farvanyoshi/battery-science-project/assets/images/method/zinc-chloride.jpg

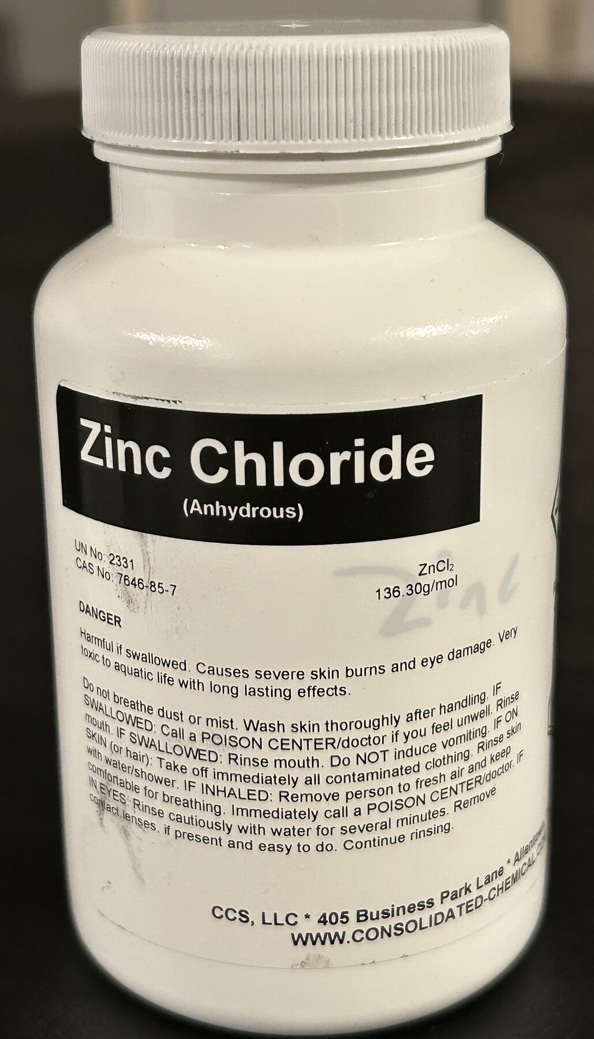
assets/images/method/zinc-chloride.jpg
