farvanyoshi/battery-science-project/assets/images/method/first-battery.jpg

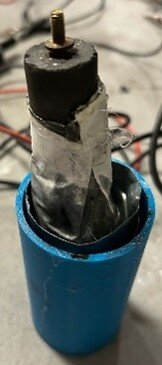
assets/images/method/first-battery.jpg
