farvanyoshi/battery-science-project/docs/abstract.pdf

Abstract
As the world transitions to renewable sources o energy, massive grid energy storage will be necessary to accommodate the variable output o these sources. Grid solutions must be ecient, sustainable, aordable, and scalable to keep up with ever-increasing demand. While lithium-ion batteries are the current frst choice or grid storage, zinc-ion batteries (ZIBs) are more sustainable and cost-eective. ZIBs have more abundant materials, lower prices, and less potential or harm. This study assesses the perormance o zinc-ion batteries made using consumer-grade materials to determine the easibility o these batteries on a commercial scale. Variations in the composition o the cathode and electrolyte were evaluated or improvements in the discharge profles and overall perormance.

Despite the heavy limitations placed on battery construction by the low-quality materials and simpler design, the batteries were able to eectively charge and discharge without a considerable loss in capacity. It was ound that the zinc chloride used in later iterations was a more dangerous and unstable electrolyte, while the addition o manganese dioxide showed substantial improvement to battery perormance in Iteration 5. Issues including short-circuiting and gas evolution while recharging demonstrated the need or improved design and construction. Nevertheless, the fndings o this experiment underscore the usage zinc-ion batteries or grid storage while emphasizing the need or signifcant optimizations in the eciency, stability, and longevity o zinc-ion batteries. Thus, this proo-o-concept study provides a oundation or urther research into aordable and sustainable battery technologies.
