farvanyoshi/battery-science-project/assets/images/intro/li-ion-discharge.png

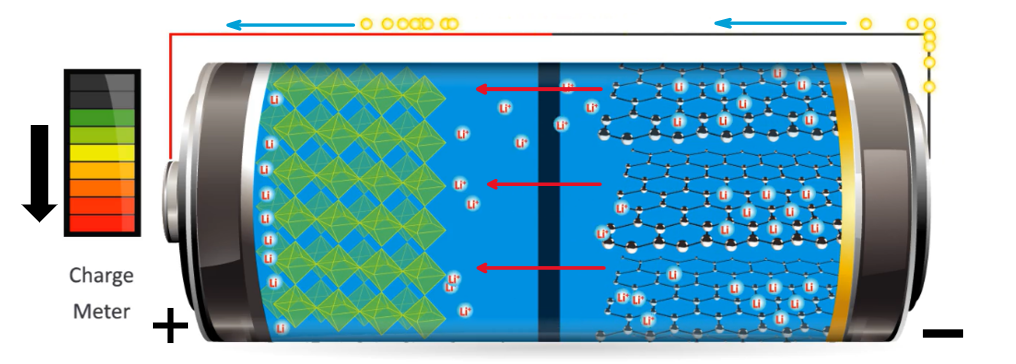
assets/images/intro/li-ion-discharge.png
