farvanyoshi/battery-science-project/assets/images/method/charge-schematic.png

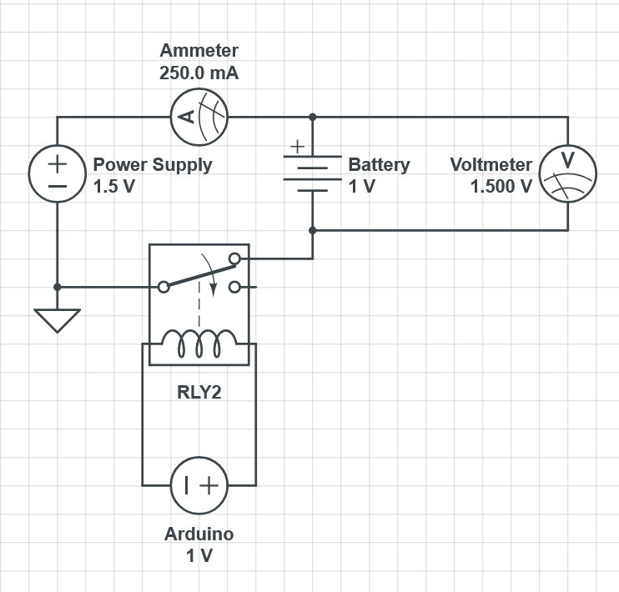
assets/images/method/charge-schematic.png
