farvanyoshi/battery-science-project/assets/images/method/current-probe.jpg

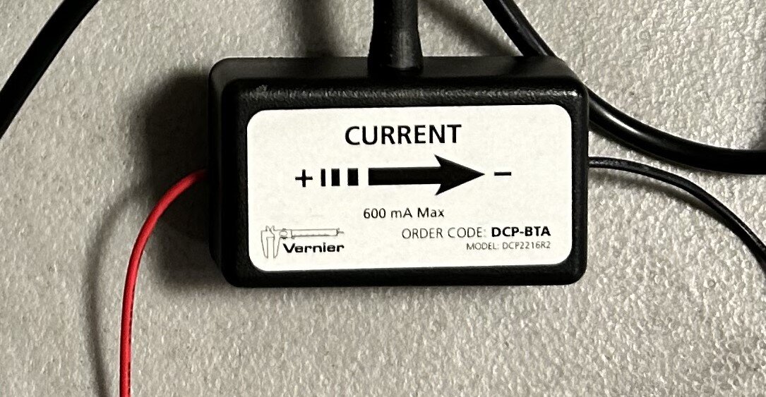
assets/images/method/current-probe.jpg
