farvanyoshi/battery-science-project/assets/images/method/discharge-schematic.png

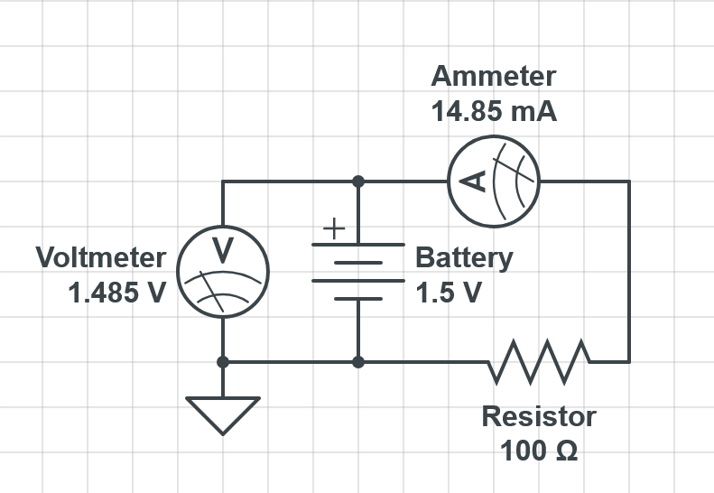
assets/images/method/discharge-schematic.png
