farvanyoshi/battery-science-project/assets/images/method/manganese-dioxide.jpg

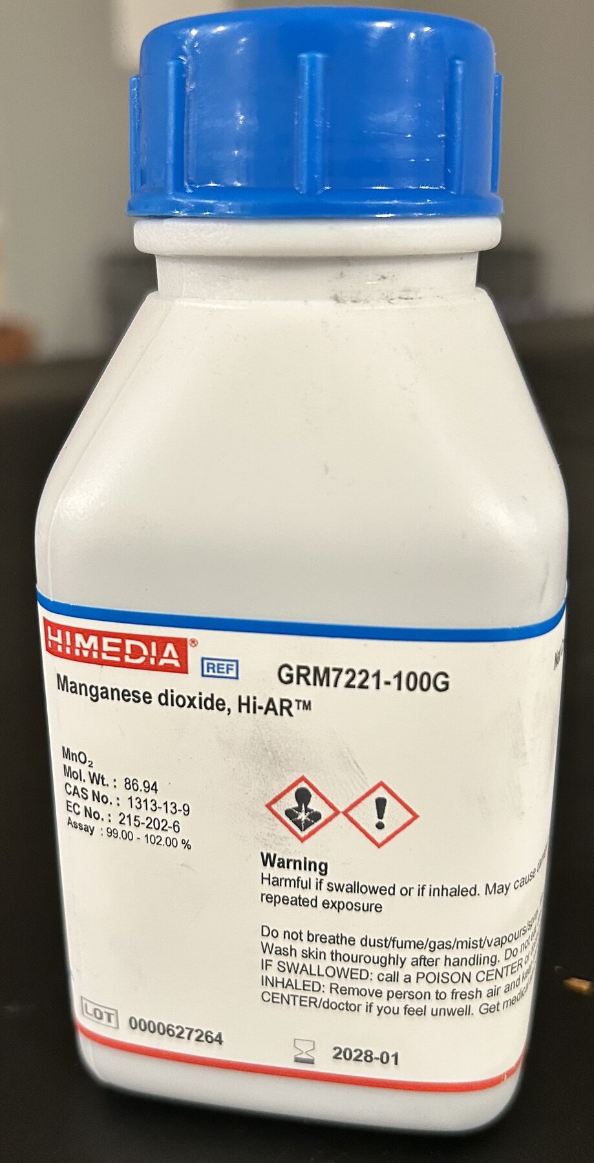
assets/images/method/manganese-dioxide.jpg
