farvanyoshi/battery-science-project/docs/VERIFICATION.md

# Verification against the submitted paper

Generated by `python -m zinclab verify` (or `make verify`). Every graph, table and number in the submitted paper
(January 2025) was compared with the data book ([`data/raw/the-data-book.xlsx`](../data/raw/the-data-book.xlsx),
through the tidy files in [`data/tidy/`](../data/tidy)). Values are compared at the precision they were printed
with. Do not edit this file by hand.

## Summary

- **Data.** The data book holds the same readings as the Logger Pro files the original graphs were made from,
  except for the few cells listed below. The tests in `analysis/tests/test_book.py` check this reading by reading.
- **Graphs.** The 31 graphs are redrawn from the data book. Of the 448 values in the statistics and integral
  boxes of the original graphs, all are reproduced except in 5 boxes, and each of those is
  explained below.
- **Curve fits.** The fits are now done on the data book's readings. They give the same coefficients,
  uncertainties, correlations and RMSEs as the original graphs.
- **Effective capacity and energy (Tables 1–4).** The submitted values were wrong. The data book formula added
  up the samples instead of integrating over time, so every value was too large by the number of samples per
  minute (6 for Iteration 2, 30 for Iterations 3 and 4). In three cells, the formula pointed at the wrong columns.
  The tables in the paper now use the integrals, and the sentences that compared these values were updated.
- **Internal resistance (Tables 5–6).** These were worked out by hand from EMF readings that are not all in the
  saved data, so they could only be partly checked. They are unchanged in the paper. See the notes below.
- **Numbers in the text.** 35 quoted values were checked. 4 were wrong and are corrected in
  the paper. The rest match.

## Changes made to the paper

| Where | Submitted | Now |
|---|---|---|
| Method | “set to measure 30 samples per minute … 1 sample every 2 seconds” (Iteration 2) | 6 samples per minute, 1 sample every 10 seconds; Iterations 3 and 4 used 30 samples per minute |
| Discussion, @Pot3b | average voltage 0.08890 V | 0.08880 V (value on the graph) |
| Discussion, @C4-C | “down to around 0.02708 A … recorded 2.5 minutes after the first” | 0.002708 A (the median) and 1 minute |
| Discussion, @cap3 | Iteration 3's effective values were “about 5 times larger” than Iteration 2's | about the same; the factor of 5 came from the different sampling rates |
| Discussion, @cap4 | Iteration 4's first discharge had a “very high” effective capacity | it had none, because the short circuit kept the voltage below 0.9 V |
| Discussion, @cap5 | Iteration 5's values “were not impressive” | they were the largest of any iteration |
| Conclusion | “The zinc chloride-based iteration 3 had by far the greatest effective capacity and effective energy.” | Iteration 5, with manganese dioxide, had the greatest |

The effective capacity and energy tables were replaced as a whole (see below). Spelling and grammar fixes are not
listed here (see the git history).

## Data book vs. Logger Pro

Every change made while splitting the data book into [`data/tidy/`](../data/tidy) is logged in
[`data/tidy/cleaning.csv`](../data/tidy/cleaning.csv). Grouped by run:

| Run | In the paper | Book rows | Columns | Change | Reason |
|---|---|---|---|---|---|
| `iteration-1/discharge-2` | no | 426–452 | potential_v, power_w | removed (54 cells) | Broken formula in the book |
| `iteration-3/discharge-1` | yes | 79–101 | current_a, potential_v, power_w | removed (69 cells) | Probe glitch: the potential drops from 0.41 V to 0.07 V and jumps to 0.65 V (struck out in Logger Pro) |
| `iteration-4/discharge-1` | yes | 3–14403 | current_a, potential_v | swapped | The book has the potential difference and current columns swapped for this run |
| `iteration-5/discharge-2` | yes | 3–6 | potential_v, power_w | removed (8 cells) | Readings before the probe settled, including a 5.087 V spike (struck out in Logger Pro) |

The readings that were removed from runs in the paper are exactly the ones that were struck out in Logger Pro, so
the original graphs did not include them either. Apart from these, the data book and Logger Pro agree to within
Logger Pro's rounding (about 10⁻⁷).

The data book also has the full length of two runs that the paper cut short: Iteration 5's first discharge ran for
240 minutes, but the paper cut both of its discharges off at 88 minutes, and the last charge of Iteration 2 ran for
120 minutes, but the paper only used the first 60. The graphs and tables keep the paper's cutoffs
(`CUTOFF` in `analysis/zinclab/spec.py`). The normalized potential graph (Vnorm) showed the whole of each run in
the original, so it still does.

## Graph readouts

The original graphs were Logger Pro screenshots with statistics boxes (minimum and maximum with their times, mean,
median, standard deviation, sample count, Δ) and integral boxes. Their values were transcribed into
[`data/original/figure-readouts.csv`](../data/original/figure-readouts.csv) and compared with the values
recomputed from the data book.

These boxes come out differently:

| Figure | Series | Original → now | Why |
|---|---|---|---|
| Cnorm | Iteration 4, Discharge 1 | min: 0.1616 → 0.1851; min_at: 471.7 → 474.0; mean: 0.3246 → 0.3492; median: 0.2813 → 0.3055; std: 0.1438 → 0.1394 | the original graph showed Iteration 4's normalized potential here, because it was made from the data book's swapped columns (now fixed) |
| C2-C | Charge 1 | std: 0.002270 → 0.002271 | the current at 12.5 min is an average the data book keeps unrounded (0.0425911 A) where Logger Pro rounded it (0.042591 A) |
| C3-D2 | Discharge 2 (1000 ohms) | min: -9.540E-05 → -9.537e-05 | Logger Pro rounded the smallest current step to −9.54e-05 A; the data book has it in full |
| Vnorm | Iteration 4, Discharge 1 | min: 0.1851 → 0.1616; min_at: 474.0 → 471.7; mean: 0.3492 → 0.3246; median: 0.3055 → 0.2813; std: 0.1394 → 0.1438 | the original graph showed Iteration 4's normalized current here, because it was made from the data book's swapped columns (now fixed) |
| P3 | Discharge 2 (1000 ohms) | min: -8.250E-05 → -8.247e-05 | the same unrounded current step as C3-D2 |

The table lists the mean and integral of each box. The last column covers every value in the box.

| Figure | Series | n | Mean (original) | Mean (now) | Integral (original) | Integral (now) | All values in the box |
|---|---|---|---|---|---|---|---|
| Ch4 | Charge 1 | 12 | 1.108 | 1.108 | — | — | matches |
| Ch4 | Charge 2 | 17 | 0.9281 | 0.9281 | — | — | matches |
| Ch4 | Charge 3 | 12 | 1.069 | 1.069 | — | — | matches |
| Cnorm | Iteration 3, Discharge 1 | 14377 | 0.07662 | 0.07662 | — | — | matches |
| Cnorm | Iteration 4, Discharge 1 | 14401 | 0.3246 | 0.3492 | — | — | **changed** (see above) |
| Cnorm | Iteration 5, Discharge 2 | 2652 | 0.1461 | 0.1461 | — | — | matches |
| C2-C | Charge 1 | 13 | 0.04067 | 0.04067 | 2.342 | 2.342 | **changed** (see above) |
| C2-C | Charge 2 | 13 | 0.03147 | 0.03147 | 1.791 | 1.791 | matches |
| C2-C | Charge 3 | 13 | 0.06236 | 0.06236 | 3.472 | 3.472 | matches |
| C2-D1 | Discharge 1 | 2881 | 0.003698 | 0.003698 | 1.775 | 1.775 | matches |
| C2-D2 | Discharge 2 | 2881 | 0.006415 | 0.006415 | 3.079 | 3.079 | matches |
| C2-D3 | Discharge 3 | 2881 | 0.006202 | 0.006202 | 2.977 | 2.977 | matches |
| C3b | Modified Iteration 3 Discharge | 14401 | 0.001617 | 0.001617 | 0.7757 | 0.7757 | matches |
| C3-C | Charge 1 | 49 | 0.009042 | 0.009042 | 0.5137 | 0.5137 | matches |
| C3-C | Charge 2 | 49 | 0.004445 | 0.004445 | 0.2484 | 0.2484 | matches |
| Pot2 | Discharge 1 | 2881 | 0.4331 | 0.4331 | — | — | matches |
| Pot2 | Discharge 2 | 2881 | 0.6501 | 0.6501 | — | — | matches |
| Pot2 | Discharge 3 | 2881 | 0.6618 | 0.6618 | — | — | matches |
| C3-D1 | Discharge 1 (10 ohms) | 14377 | 0.003884 | 0.003884 | 1.887 | 1.887 | matches |
| C3-D2 | Discharge 2 (1000 ohms) | 14401 | 0.0006280 | 0.0006280 | 0.3014 | 0.3014 | **changed** (see above) |
| C3-D3 | Discharge 3 (100 ohms) | 14401 | 0.005154 | 0.005154 | 2.474 | 2.474 | matches |
| C4-C | Charge 1 | 49 | 0.1059 | 0.1059 | 6.221 | 6.221 | matches |
| C4-C | Charge 2 | 44 | 0.005201 | 0.005201 | 0.2187 | 0.2187 | matches |
| C4-C | Charge 3 | 49 | 0.07162 | 0.07162 | 4.197 | 4.197 | matches |
| C4-D1 | Discharge 1 | 14401 | 0.3524 | 0.3524 | 169.1 | 169.1 | matches |
| C4-D2 | Discharge 2 | 14401 | 0.0008709 | 0.0008709 | 0.4180 | 0.4180 | matches |
| C4-D3 | Discharge 3 | 14401 | 0.006575 | 0.006575 | 3.156 | 3.156 | matches |
| C5-D1 | Discharge 1 | 5303 | 0.001741 | 0.001741 | 0.1538 | 0.1538 | matches |
| C5-D2 | Discharge 2 | 2652 | 0.02385 | 0.02385 | 2.106 | 2.106 | matches |
| CS | NiMH Discharge 1 | 14401 | 0.0009516 | 0.0009516 | 0.4568 | 0.4568 | matches |
| Vnorm | Iteration 2, Discharge 1 | 2881 | 0.7294 | 0.7294 | — | — | matches |
| Vnorm | Iteration 3, Discharge 1 | 14377 | 0.1956 | 0.1956 | — | — | matches |
| Vnorm | Iteration 4, Discharge 1 | 14401 | 0.3492 | 0.3246 | — | — | **changed** (see above) |
| Vnorm | Iteration 5, Discharge 1 | 14401 | 0.7650 | 0.7650 | — | — | matches |
| Pot3b | Modified Iteration 3 Discharge | 14401 | 0.08880 | 0.08880 | — | — | matches |
| Pot3 | Discharge 1 (10 ohms) | 14377 | 0.1131 | 0.1131 | — | — | matches |
| Pot3 | Discharge 2 (1000 ohms) | 14401 | 0.8425 | 0.8425 | — | — | matches |
| Pot3 | Discharge 3 (100 ohms) | 14401 | 0.5831 | 0.5831 | — | — | matches |
| Pot4 | Discharge 1 | 14401 | 0.03041 | 0.03041 | — | — | matches |
| Pot4 | Discharge 2 | 14401 | 0.8254 | 0.8254 | — | — | matches |
| Pot4 | Discharge 3 | 14401 | 0.7268 | 0.7268 | — | — | matches |
| Pot5 | Discharge 1 | 5303 | 1.819 | 1.819 | — | — | matches |
| Pot5 | Discharge 2 | 2648 | 0.2432 | 0.2432 | — | — | matches |
| PotS | NiMH Discharge 1 | 14401 | 1.261 | 1.261 | — | — | matches |
| P2 | Discharge 1 | — | — | — | 0.7843 | 0.7843 | matches |
| P2 | Discharge 2 | — | — | — | 2.055 | 2.055 | matches |
| P2 | Discharge 3 | — | — | — | 2.031 | 2.031 | matches |
| P3 | Discharge 1 (10 ohms) | 14377 | 0.0006161 | 0.0006161 | 0.3056 | 0.3056 | matches |
| P3 | Discharge 2 (1000 ohms) | 14401 | 0.0005392 | 0.0005392 | 0.2588 | 0.2588 | **changed** (see above) |
| P3 | Discharge 3 (100 ohms) | 14401 | 0.003211 | 0.003211 | 1.541 | 1.541 | matches |
| P4 | Discharge 1 | 14401 | 0.01261 | 0.01261 | 6.052 | 6.052 | matches |
| P4 | Discharge 2 | 14401 | 0.0007199 | 0.0007199 | 0.3456 | 0.3456 | matches |
| P4 | Discharge 3 | 14401 | 0.004822 | 0.004822 | 2.315 | 2.315 | matches |
| P5 | Discharge 1 | 5303 | 0.003193 | 0.003193 | 0.2821 | 0.2821 | matches |
| P5 | Discharge 2 | 2648 | 0.01943 | 0.01943 | 1.710 | 1.710 | matches |

## Curve fits (EMF while charging)

The model is EMF = A·e^(−Ct) + B, fitted by least squares. The uncertainties are one standard error. Iteration 2's
original fits were never saved in a Logger Pro file, so their coefficients are the four-digit values on the
original graph. Iteration 3's come from `logger-pro/files/emf v. time, iteration 3.cmbl`.

| Figure | Series | A, B, C (original) | A, B, C (fitted to the data book) | Correlation / RMSE (original) | Correlation / RMSE (now) |
|---|---|---|---|---|---|
| Ch2 | Charge 1 | -0.1921 ± 0.03556, 0.9885 ± 0.04032, 0.01767 ± 0.006351 | -0.1921 ± 0.03556, 0.9885 ± 0.04032, 0.01767 ± 0.006351 | 0.9901 / 0.005595 | 0.9901 / 0.005595 |
| Ch2 | Charge 2 | -0.06427 ± 0.007907, 1.056 ± 0.006404, 0.05027 ± 0.01871 | -0.06427 ± 0.007907, 1.056 ± 0.006404, 0.05027 ± 0.01871 | 0.9433 / 0.005862 | 0.9433 / 0.005862 |
| Ch2 | Charge 3 | -0.3747 ± 0.01163, 1.018 ± 0.01524, 0.03686 ± 0.004208 | -0.3747 ± 0.01163, 1.018 ± 0.01524, 0.03686 ± 0.004208 | 0.9963 / 0.008360 | 0.9963 / 0.008360 |
| Ch3 | Charge 1 | -0.6980 ± 0.5103, 1.338 ± 0.01974, 0.2174 ± 0.1311 | -0.6980 ± 0.5103, 1.338 ± 0.01974, 0.2174 ± 0.1311 | 0.8066 / 0.05570 | 0.8066 / 0.05570 |
| Ch3 | Charge 2 | -0.2133 ± 0.01521, 1.466 ± 0.002606, 0.1045 ± 0.01032 | -0.2133 ± 0.01521, 1.466 ± 0.002606, 0.1045 ± 0.01032 | 0.9920 / 0.005458 | 0.9920 / 0.005458 |

## Effective capacity and energy

The paper defines the effective capacity (energy) as the area under the current (power) curve while the
potential difference is above 0.9 V. The data book used
`SUM(C3:INDEX(C:C, MAX(IF(B1:B10000>0.9, ROW(B1:B10000)))))`. This is the sum of every sample from the start
of the discharge to the last sample above 0.9 V. The sum leaves out the time step, so it is not an integral. For
Iteration 4, discharge 1, and both discharges of Iteration 5, the formula referenced the potential and current
columns the wrong way round. It returned the first sample instead. The corrected integrals use the same range
(start of the discharge to the last sample above 0.9 V) with the trapezoidal rule.

| Iteration | Discharge | Paper (A·min / W·min) | Data book formula, recomputed | Corrected integral | Explanation |
|---|---|---|---|---|---|
| 2 | 1 | 0 / 0 | 0 / 0 | **0 / 0** | never above 0.9 V (unchanged) |
| 2 | 2 | 0.5647 / 0.5200 | 0.5647 / 0.5200 | **0.09270 / 0.08535** | sum of samples, not an integral |
| 2 | 3 | 1.196 / 1.125 | 1.196 / 1.125 | **0.1977 / 0.1860** | sum of samples, not an integral |
| 3 | 1 | 0 / 0 | 0 / 0 | **0 / 0** | never above 0.9 V (unchanged) |
| 3 | 2 | 2.818 / 2.316 | 2.818 / 2.778 | **0.09389 / 0.09255** | sum of samples, not an integral; the paper's energy (2.316) was also mistyped from the data book (2.778) |
| 3 | 3 | 5.648 / 5.498 | 5.648 / 5.498 | **0.1879 / 0.1829** | sum of samples, not an integral |
| 4 | 1 | 1.009 / 0.09455 | 1.009 / 0.09455 | **0 / 0** | formula read the wrong columns: first current and first power sample |
| 4 | 2 | 0.8681 / 0.8073 | 0.8681 / 0.8073 | **0.02890 / 0.02687** | sum of samples, not an integral |
| 4 | 3 | 0.02586 / 0.02339 | 0.02586 / 0.02339 | **0.0005643 / 0.0005100** | sum of samples, not an integral |
| 5 | 1 | 2.093 / 0.004071 | 2.093 / 0.004071 | **0.1538 / 0.2821** | formula read the wrong columns: first potential difference and first power sample |
| 5 | 2 | 1.310 / 0.2138 | — (see explanation) | **1.125 / 1.400** | formula read the wrong columns: the first potential difference and power samples, which are readings that were struck out in Logger Pro and are removed from the tidy data |

## Internal resistance

Each table value r was turned back into the EMF it implies, ε = V + I·r, using the first (start) or last (end)
sample of the discharge. That EMF was then compared with the open-circuit readings in the charge data. A ✓ means
a saved reading within 0.5 % was found. The other EMF values were probably read from the meters by hand and not
saved. For Iteration 4, discharge 1 (the short circuit), the implied EMF of about 5–7 V is impossible for this
cell, so those two values are almost certainly wrong. No correct value can be computed without the missing EMF
readings, so the tables are left as submitted.

| Iteration | Discharge | At | Paper r (Ω) | Measured V, I | EMF implied by r = (ε − V)/I | Closest EMF reading in the charge data |
|---|---|---|---|---|---|---|
| 2 | 1 | start | 78.66 | 0.5938 V, 0.00570 A | 1.0424 V | 1.0424 V ✓ |
| 2 | 1 | end | 151.81 | 0.3599 V, 0.00290 A | 0.8000 V | 0.8057 V |
| 2 | 2 | start | 18.07 | 0.9615 V, 0.00853 A | 1.1156 V | 1.0611 V |
| 2 | 2 | end | 28.32 | 0.5127 V, 0.00416 A | 0.6305 V | 0.6996 V |
| 2 | 3 | start | 4.146 | 1.0176 V, 0.01049 A | 1.0611 V | 1.0611 V ✓ |
| 2 | 3 | end | 45.43 | 0.5064 V, 0.00425 A | 0.6996 V | 0.6996 V ✓ |
| 3 | 1 | start | 2.406 | 0.5781 V, 0.05070 A | 0.7001 V | 1.1017 V |
| 3 | 1 | end | 150.90 | 0.0952 V, 0.00177 A | 0.3628 V | 1.1017 V |
| 3 | 2 | start | 56.55 | 1.1484 V, 0.00145 A | 1.2304 V | 1.2325 V ✓ |
| 3 | 2 | end | 174.74 | 0.7339 V, 0.00051 A | 0.8239 V | 1.1017 V |
| 3 | 3 | start | 26.70 | 1.1641 V, 0.01143 A | 1.4691 V | 1.4694 V ✓ |
| 3 | 3 | end | 93.30 | 0.4316 V, 0.00395 A | 0.8000 V | 1.1017 V |
| 4 | 1 | start | 4.823 | 0.0937 V, 1.00899 A | 4.9601 V | 1.2798 V |
| 4 | 1 | end | 36.05 | 0.0151 V, 0.19608 A | 7.0837 V | 1.2798 V |
| 4 | 2 | start | 89.87 | 0.9933 V, 0.00114 A | 1.0962 V | 1.0962 V ✓ |
| 4 | 2 | end | 188.3 | 0.7940 V, 0.00084 A | 0.9521 V | 0.9521 V ✓ |
| 4 | 3 | start | 2.350 | 0.9085 V, 0.00925 A | 0.9302 V | 0.9302 V ✓ |
| 4 | 3 | end | 23.73 | 0.6311 V, 0.00551 A | 0.7619 V | 0.7620 V ✓ |
| 5 | 1 | start | 75.71 | 2.0927 V, 0.00195 A | 2.2400 V | no charge readings used |
| 5 | 1 | end | 108.98 | 1.5913 V, 0.00132 A | 1.7347 V | no charge readings used |
| 5 | 2 | start | 4.282 | 1.6306 V, 0.16327 A | 2.3297 V | no charge readings used |
| 5 | 2 | end | 182.3 | 0.0360 V, 0.00364 A | 0.7002 V | no charge readings used |

## Values quoted in the text

| Where | Quantity | Paper | From the data | Status |
|---|---|---|---|---|
| Method | samples per minute recorded for Iteration 2 | 30 | 6.000 | **corrected to 6 (one every 10 s)** |
| Discussion, @C2-D3 | maximum current of Iteration 2 (A) | 0.01049 | 0.01049 | matches |
| Discussion, @C2-D2 | charge of Discharge 2 (A·min) | 3.079 | 3.079 | matches |
| Discussion, @C2-D2 | the same in coulombs | 184.7 | 184.7 | matches |
| Discussion, @C2-D2 | the same in mAh | 51.32 | 51.32 | matches |
| Discussion, @C2-D2 | how many times less than a 1100 mAh AA cell | 21.43 | 21.44 | matches (worked out from rounded values) |
| Discussion, @Ch2 | predicted maximum EMF, charge 1 (V) | 0.9885 | 0.9885 | matches |
| Discussion, @Ch2 | predicted maximum EMF, charge 2 (V) | 1.056 | 1.056 | matches |
| Discussion, @Ch2 | predicted maximum EMF, charge 3 (V) | 1.018 | 1.018 | matches |
| Discussion, @Ch2 | measured maximum EMF, charge 2 (V) | 1.061 | 1.061 | matches |
| Discussion, @C3-D1 | maximum current (A) | 0.05 | 0.05070 | matches |
| Discussion, @Pot3b | average voltage of the modified Iteration 3 (V) | 0.08890 | 0.08880 | **corrected to 0.08880** |
| Discussion, @C3b | average current of the modified Iteration 3 (mA) | 1.617 | 1.617 | matches |
| Discussion, @Ch3 | predicted maximum EMF, charge 1 (V) | 1.338 | 1.338 | matches |
| Discussion, @Ch3 | predicted maximum EMF, charge 2 (V) | 1.466 | 1.466 | matches |
| Discussion, @C4-D1 | total charge (A·h) | 2.818 | 2.819 | matches (worked out from rounded values) |
| Discussion, @C4-D1 | times the best discharge of Iteration 2 | 55 | 54.93 | matches |
| Discussion, @C4-D1 | maximum current (A) | 1.009 | 1.009 | matches |
| Discussion, Eq. 4-1-res | maximum terminal voltage (V) | 0.09371 | 0.09371 | matches |
| Discussion, Eq. 4-1-res | external resistance V/I (Ω) | 0.09287 | 0.09287 | matches |
| Discussion, Eq. short-r | internal resistance for ε = 1.5 V (Ω) | 1.394 | 1.394 | matches |
| Discussion, @C4-C | first current of charge 2 (A) | 0.1062 | 0.1062 | matches |
| Discussion, @C4-C | typical current after the first reading (A, median) | 0.02708 | 0.002708 | **corrected to 0.002708** |
| Discussion, @C4-C | minutes between the first two readings | 2.5 | 1.000 | **corrected to 1** |
| Discussion, @Pot5 | minutes above 1.8 V in discharge 1 | 40 | 42.15 | matches (rounded in the text) |
| Discussion, @C5-D2 | charge of discharge 2 (A·min) | 2.106 | 2.106 | matches |
| Discussion, @C5-D2 | the same in coulombs | 126.36 | 126.3 | matches (worked out from rounded values) |
| Discussion, @C5-D2 | the same in mAh | 35.1 | 35.10 | matches |
| Discussion, @CS | charge of the NiMH cell (A·min) | 0.4568 | 0.4568 | matches |
| Discussion, @C4-D2 | charge of Iteration 4, discharge 2 (A·min) | 0.4180 | 0.4180 | matches |
| Discussion, @P2 | energy of Iteration 2, discharge 2 (W·min) | 2.055 | 2.055 | matches |
| Discussion, @P2 | the same in mWh | 34.25 | 34.25 | matches |
| Discussion, @P4 | average power of Iteration 4, discharge 3 (mW) | 4.822 | 4.822 | matches |
| Discussion, @P5 | energy of Iteration 5, discharge 2 (W·min) | 1.710 | 1.710 | matches |
| Discussion, @P5 | the same in joules | 102.6 | 102.6 | matches |
