farvanyoshi/battery-science-project/logger-pro/converted/project test 2/dataset_128.csv

Time [h] (id 121) | Current [A] (id 124) | Potential [V] (id 135)
0.0 | 0.0730895996094 | 0.90274810791
0.00166666666667 | 0.0715255737305 | 0.887107849121
0.00333333333333 | 0.0715255737305 | 0.87776184082
0.005 | 0.0705909729004 | 0.871467590332
0.00666666666667 | 0.0705909729004 | 0.86841583252
0.00833333333333 | 0.0705909729004 | 0.862121582031
0.01 | 0.0696563720703 | 0.862121582031
0.0116666666667 | 0.0696563720703 | 0.855827331543
0.0133333333333 | 0.0693511962891 | 0.855827331543
0.015 | 0.0690269470215 | 0.855827331543
0.0166666666667 | 0.068416595459 | 0.85277557373
0.0183333333333 | 0.0687217712402 | 0.849723815918
0.02 | 0.0677871704102 | 0.849723815918
0.0216666666667 | 0.068416595459 | 0.840377807617
0.0233333333333 | 0.068416595459 | 0.84342956543
0.025 | 0.068416595459 | 0.840377807617
0.0266666666667 | 0.0674819946289 | 0.84342956543
0.0283333333333 | 0.0674819946289 | 0.837135314941
0.03 | 0.0668525695801 | 0.840377807617
0.0316666666667 | 0.0668525695801 | 0.840377807617
0.0333333333333 | 0.0668525695801 | 0.834083557129
0.035 | 0.0665473937988 | 0.831031799316
0.0366666666667 | 0.0668525695801 | 0.837135314941
0.0383333333333 | 0.0668525695801 | 0.831031799316
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
