farvanyoshi/battery-science-project/logger-pro/converted/expo tester/dataset_758.csv

Time [h] (id 759) | Current [mA] (id 761)
0.0 | 49.6025
0.002777778 | 49.6025
0.005555556 | 49.6025
0.008333333 | 48.6875
0.011111111 | 48.6875
0.013888889 | 48.9925
0.016666667 | 49.2975
0.019444444 | 48.6875
0.022222222 | 48.6875
0.025 | 48.6875
0.027777778 | 48.6875
0.030555556 | 48.6875
0.033333333 | 48.6875
0.036111111 | 48.3825
0.038888889 | 48.0775
0.041666667 | 47.7725
0.044444444 | 48.0775
0.047222222 | 46.245
0.05 | 45.94
0.052777778 | 45.33
0.055555556 | 45.635
0.058333333 | 46.245
0.061111111 | 46.245
0.063888889 | 46.245
0.066666667 | 45.94
0.069444444 | 45.025
0.072222222 | 45.94
0.075 | 45.33
0.077777778 | 45.635
0.080555556 | 45.635
0.083333333 | 45.33
0.086111111 | 45.635
0.088888889 | 45.635
0.091666667 | 45.635
0.094444444 | 45.025
0.097222222 | 45.635
0.1 | 45.33
0.102777778 | 45.635
0.105555556 | 44.72
0.108333333 | 44.72
0.111111111 | 45.025
0.113888889 | 45.635
0.116666667 | 45.33
0.119444444 | 45.33
0.122222222 | 44.72
0.125 | 45.33
0.127777778 | 45.33
0.130555556 | 45.33
0.133333333 | 44.72
0.136111111 | 44.415
0.138888889 | 44.415
0.141666667 | 45.33
0.144444444 | 45.025
0.147222222 | 45.025
0.15 | 44.415
0.152777778 | 44.415
0.155555556 | 44.72
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
