farvanyoshi/battery-science-project/logger-pro/converted/expo tester/dataset_782.csv

Time [h] (id 785) | Current [mA] (id 788)
0.0 | 49.6025
0.002777778 | 49.9075
0.005555556 | 49.9075
0.008333333 | 49.6025
0.011111111 | 49.6025
0.013888889 | 49.2975
0.016666667 | 49.9075
0.019444444 | 49.6025
0.022222222 | 49.6025
0.025 | 49.6025
0.027777778 | 49.6025
0.030555556 | 49.6025
0.033333333 | 49.2975
0.036111111 | 49.6025
0.038888889 | 49.2975
0.041666667 | 49.2975
0.044444444 | 49.2975
0.047222222 | 49.2975
0.05 | 49.2975
0.052777778 | 49.2975
0.055555556 | 49.2975
0.058333333 | 48.9925
0.061111111 | 48.9925
0.063888889 | 48.9925
0.066666667 | 48.9925
0.069444444 | 49.2975
0.072222222 | 48.9925
0.075 | 48.9925
0.077777778 | 48.9925
0.080555556 | 48.9925
0.083333333 | 48.9925
0.086111111 | 48.9925
0.088888889 | 48.9925
0.091666667 | 48.6875
0.094444444 | 48.6875
0.097222222 | 48.6875
0.1 | 48.6875
0.102777778 | 48.6875
0.105555556 | 48.6875
0.108333333 | 48.6875
0.111111111 | 48.3825
0.113888889 | 48.3825
0.116666667 | 48.6875
0.119444444 | 48.3825
0.122222222 | 48.3825
0.125 | 48.6875
0.127777778 | 48.3825
0.130555556 | 48.3825
0.133333333 | 48.3825
0.136111111 | 48.0775
0.138888889 | 48.3825
0.141666667 | 47.7725
0.144444444 | 48.3825
0.147222222 | 48.0775
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
