farvanyoshi/battery-science-project/docs/project-logbook.pdf

# Project Logbook

## Evaluating the Potential of Zinc-ion Batteries

The goal of this project is to investigate more sustainable and safe alternatives to current batteries. 4 major batteries now:
Alkaline: nontoxic, safe
- Not rechargeable
- Lower shelf life due to internal reactions

Ni-MH: Safe and powerful, nontoxic
- High rate of energy dissipation when not in use

Lead-acid: lasts a very long time, works in any weather, for electronics that won't be touched often
- Super toxic

Li-ion: Powerful, rechargeable, powers all rechargeable electronics
- Has a flammable organic solvent

None are safe and long-lasting (as in low self-discharge, low internal reactions, rechargeable, and hopefully sustainable), so maybe we can find something that is better for that

# Goal

Tuesday, August 20, 2024

First Voltaic Cell Page 1

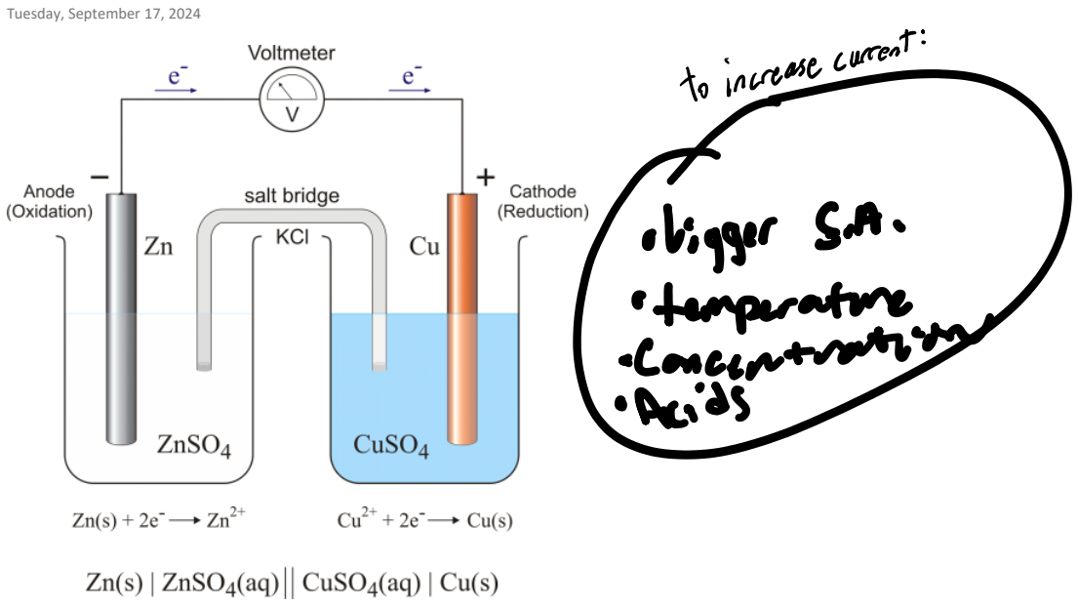
[picture p44: figure]
Tuesday, September 17, 2024

Resources we are provided: Zinc and copper metals and sulfates

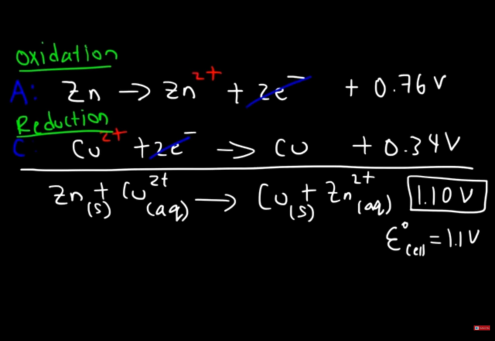
[picture p45: figure]

Materials:
Zinc (metal)
Copper (metal)
Sulfuric Acid
Beaker
Salt Bridge (KCl)
some sort of load for the system

Cell Formula:

Procedure:
1. Use sulfuric acid to create zinc and copper (II) sulfates in water
2. Pour each sulfate into a beaker
3. Insert respective metal electrode into aqueous solution, with wire attaching to each
4. Set up the load by connecting it to the electrodes with wires

### First Cell

First Voltaic Cell Page 2

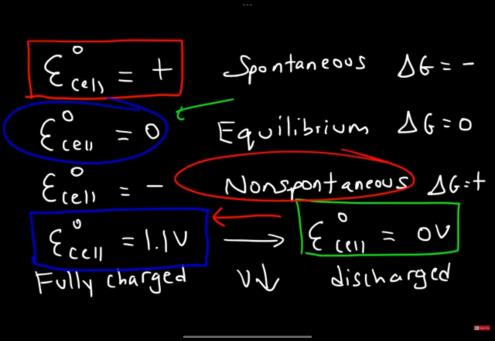
[picture p46: figure]
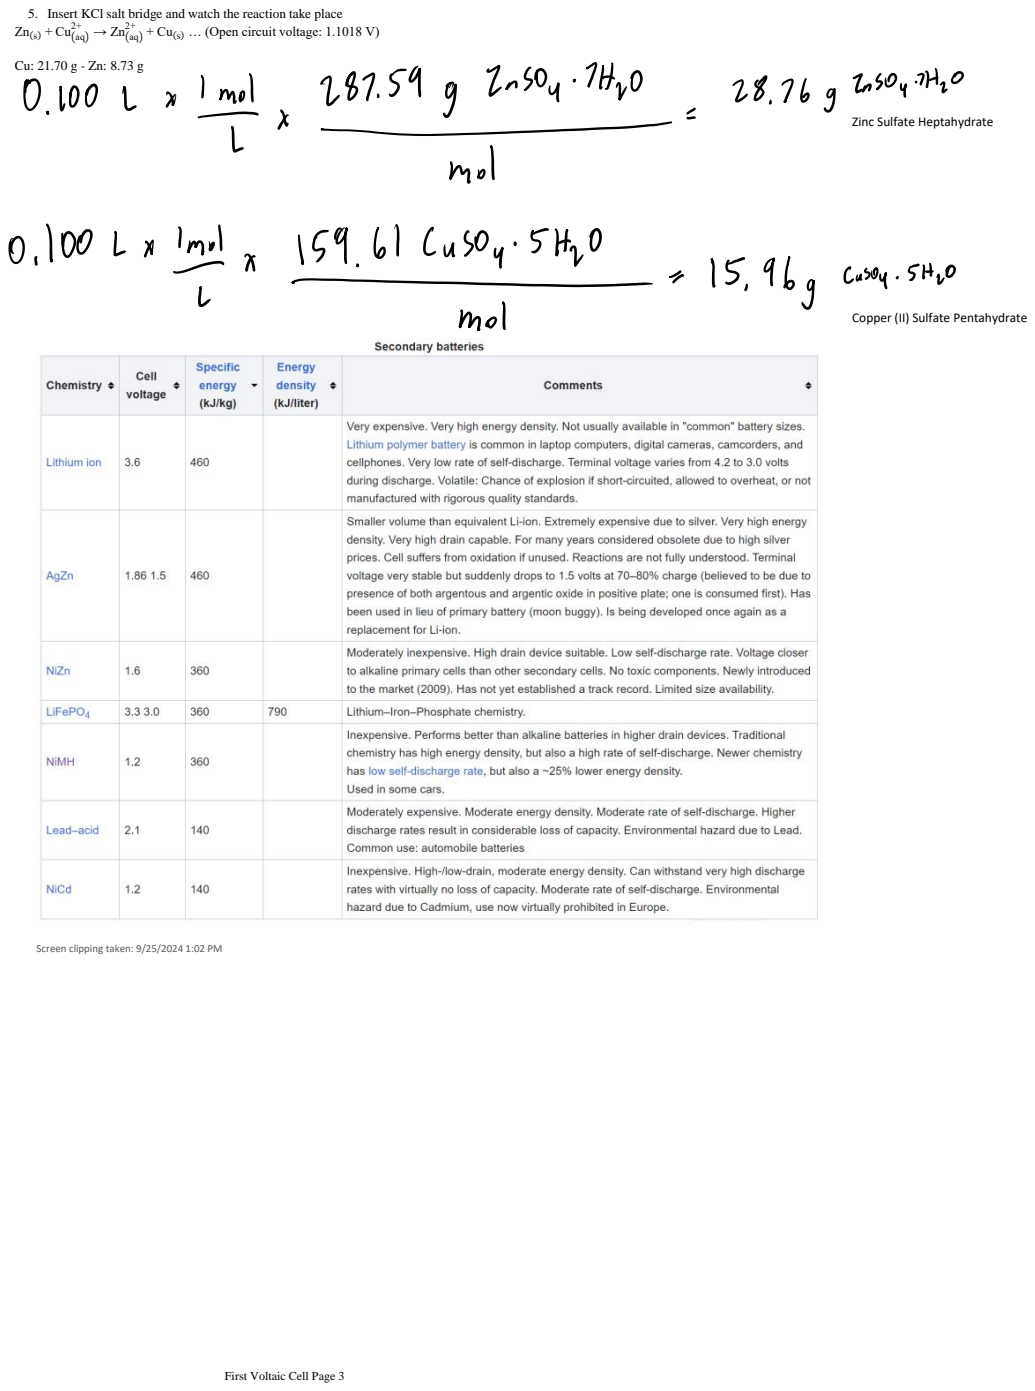
[picture p47: page 4]
pe circ it volt ge: 1.1018 V

5. Insert KCl salt bridge and watch the reaction take place

Zinc Sulfate Heptahydrate

Copper (II) Sulfate Pentahydrate

Screen clipping taken: 9/25/2024 1:02 PM

First Voltaic Cell Page 3

Created a voltaic cell using zinc, zinc sulfate, copper, and copper sulfate Cu: 21.70 g - Zn: 8.73 g

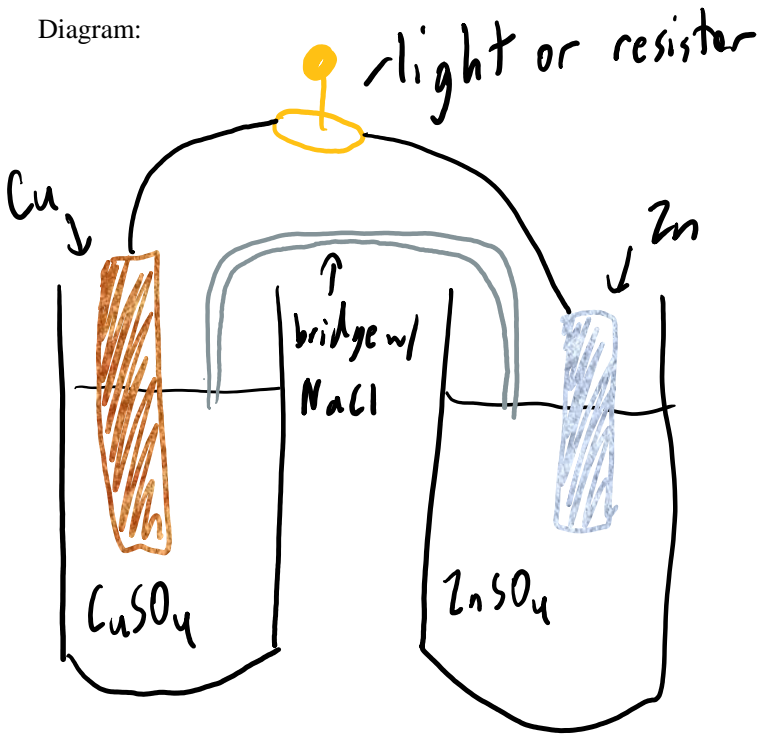
[picture p48: figure]
Diagram:

Tested voltage
1.02 V with no resistance
0.52 V with 1000 ohm resistor
= so about 1000 ohms internal resistance: very high

Tested current
About .8 mA with no resistance
A little under the 1.1 mA predicted
Current varied with level of NaCl in bridge
Heat increased the current a bit

Lightbulb could not turn on, too much resistance so very low voltage

Things learned:

Concentration, heat, and SA are the biggest factors for resistance (and so current)
- [NaCl] allows for transfer of ions across bridge, which was the limiting factor Heat = more redox reactions = more e⁻
- released
- More SA means more reactions

Need to find ways to lower resistance and increase current

# Basic Cell: Further Testing

Monday, September 23, 2024

First Voltaic Cell Page 4

- 1 V is good, but | , so the high resistance is ruining current
- To change V, we will use other materials, but not yet
Most batteries have only one electrolyte, not two like ours
- This means no salt bridge, but the electrodes must not react with electrolyte without releasing charge
- This will also lower resistance, especially if solvent is conductive

Goal:
- find ways to lower without super high concentrations
- Make a battery using only one electrolyte
- Try to find a reversible reaction if possible (it's ok if we can't), so we can make a rechargeable battery

First Voltaic Cell Page 5

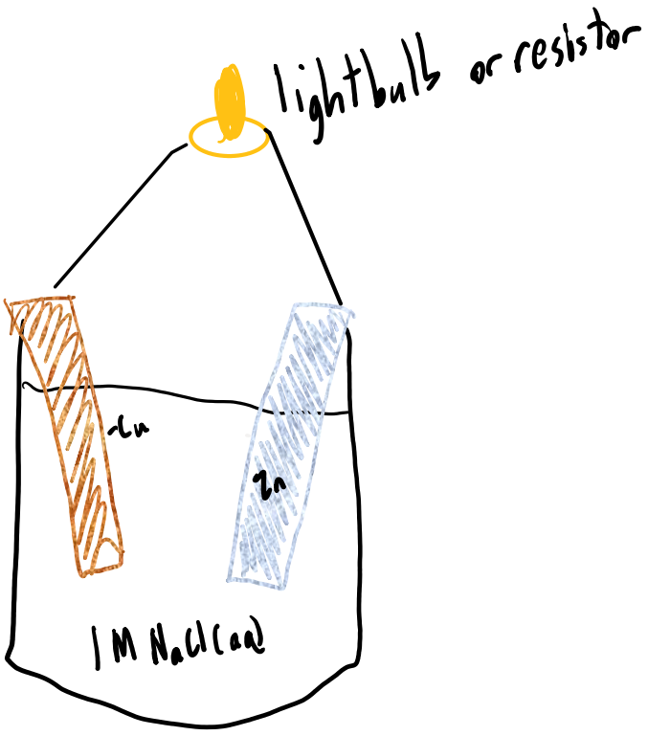
[picture p49: figure]

Measured voltage with 1000 ohm resistor: 0.8-0.9 V Measured voltage with a 100 ohms resistor: 0.4 V

Used resistance box for variable resistance
Used 1 M resistance to test cell potential, got 0.9 V

Since it was about half with 100 ohms, the internal resistance is 100 ohms Current:

Redid experiment with 2 M NaCl concentration
New resistance was 50 ohms

Last attempt at 4 M NaCl, V decreased
Possible reasons:
Max reaction rate of the zinc and copper, and concentrations were going down

- Excess sodium ions getting in the way?

Reactions:
Anode (Zn):
Cathode (Cu):
- There isn't any copper to reduce
- Sodium is essentially impossible to reduce

# Voltaic Cell in 1 Beaker

Wednesday, September 25, 2024

First Voltaic Cell Page 6

0.9 V =
100 Ohms, resistance (because voltage halves at 100 ohms from box) with 1 M NaCl (aq) as electrolyte

50 ohms in 2 M NaCl

Lowered V at 4 M
Possible reasons:
hitting max reaction rate of the zinc and copper, this is only limited by the surface area of the electrodes Maybe excess sodium ions are getting in the way?

Zinc is the stronger reducing agent, copper reduces and zinc oxidizes

Anode (Zn metal):

0.78 V
Cathode:
- Can't be zinc since that is the anode
- There aren't any copper ions to reduce
- Sodium reduction is extremely unfavorable and is almost guaranteed not to happen
- Leaves only water
- So it must be water

But this reaction is highly unfavorable (-0.8 V)
- Here, the hydrogen is being reduced, which is unfavorable
- Reduction of sodium and chlorine is obviously highly unfavorable

There should be a slow production of hydrogen ions
Solution should be turning basic over time
- next thing to test

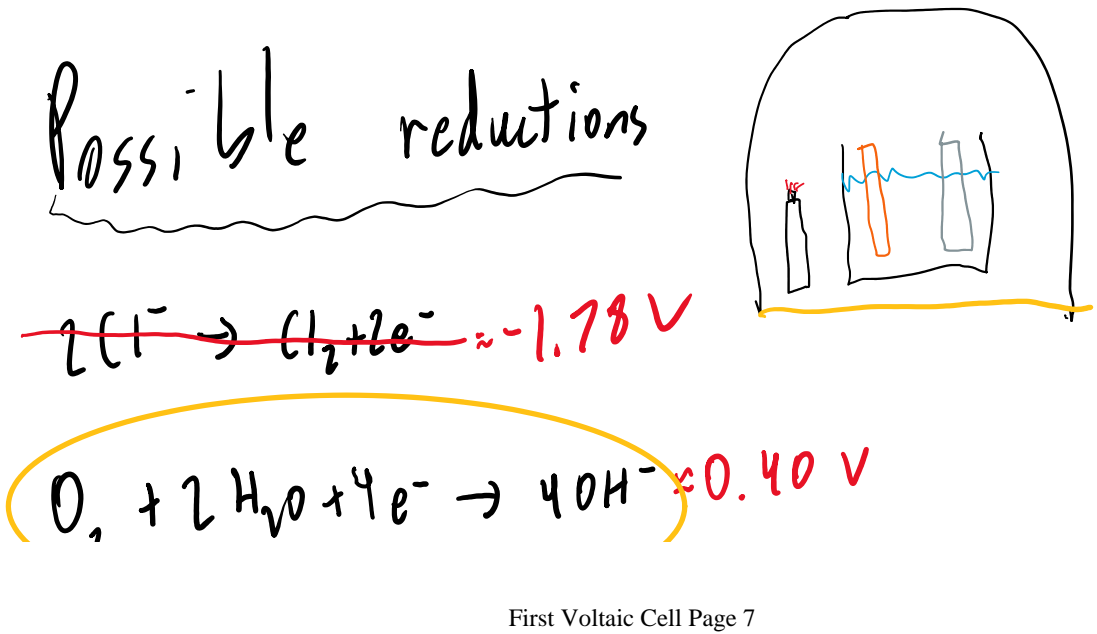
[picture p50: figure]
First Voltaic Cell Page 7
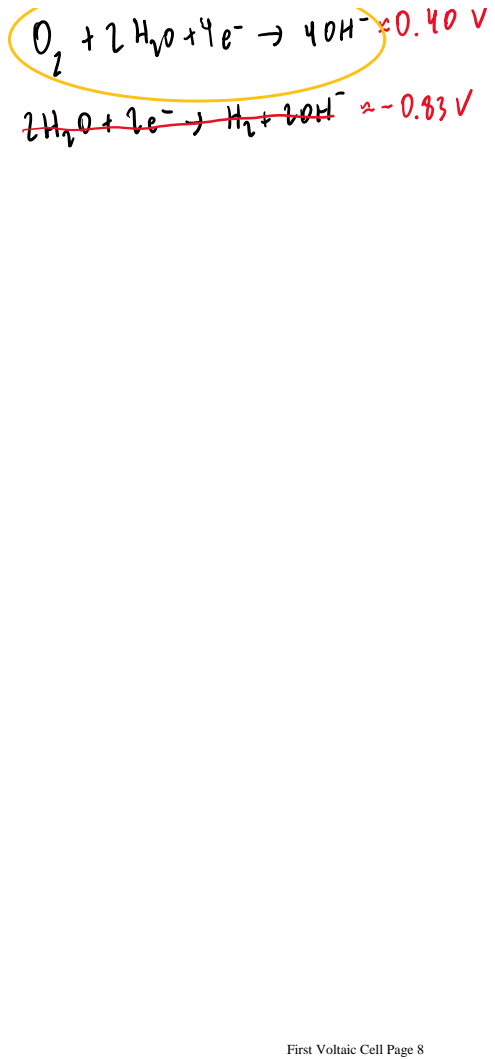
[picture p51: page 9]

First Voltaic Cell Page 8

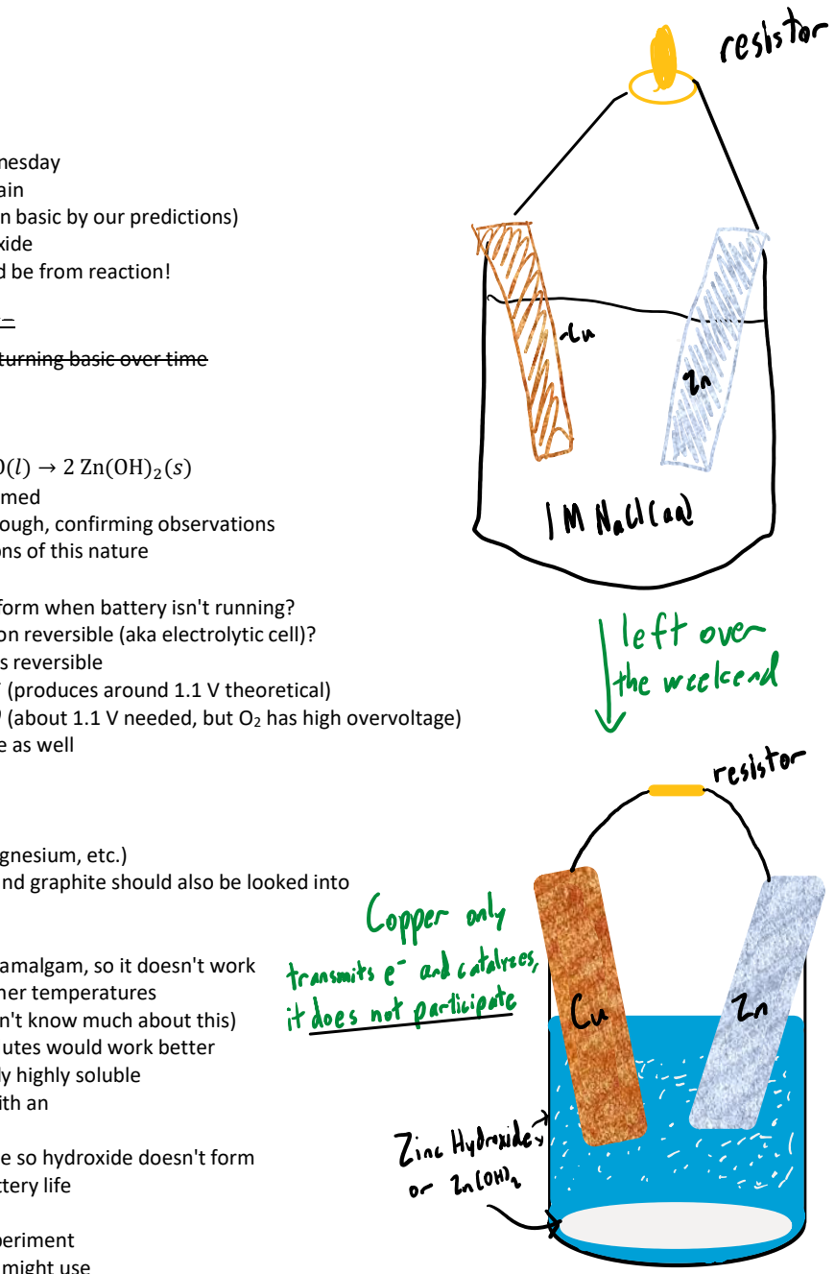
[picture p52: figure]
(produces around 1.1 V theoretical)

On Friday, we recreated our cell from Wednesday
Today, we noticed the white precipitate again
pH: 7, completely neutral (should have been basic by our predictions)
- Means there was no dissolved hydroxide
- However! The white precipitate could be from reaction!
Most likely reaction:
- This would imply that the reaction is turning basic over time But it didn't!

Overall reaction:
- Thus, no hydroxide ions are being formed
Zinc Hydroxide will precipitate out though, confirming observations
- Need to try to limit side reactions of this nature
Questions
- Does zinc hydroxide still form when battery isn't running?
- Is zinc hydroxide formation reversible (aka electrolytic cell)?

○

- Besides zinc hydroxide, the reaction is reversible

(about 1.1 V needed, but O2 has high overvoltage)
- Need to investigate overvoltage as well
- More research is needed

NEXT STEPS:
Test other electrodes (aluminum, magnesium, etc.)
- Unused electrodes like iodine and graphite should also be looked into

Look into other electrolytes
Conductive liquids?
- Mercury: will create zinc amalgam, so it doesn't work
- Gallium: needs much higher temperatures
- Something organic? (I don't know much about this)

○

I don't think other dissolved solutes would work better
- Sodium chloride is already highly soluble
- Maybe replace copper with an

○

New reduction/cathode reaction
Find something better to reduce so hydroxide doesn't form
- Side reactions will kill battery life

○

Begin writing procedure
- Already have conducted an experiment
- Talk about what electrodes we might use
- Explain the difference between conductive liquids and dissolved solutes

## Identifying the Reaction

Monday, September 30, 2024

First Voltaic Cell Page 9

## Reaction Research

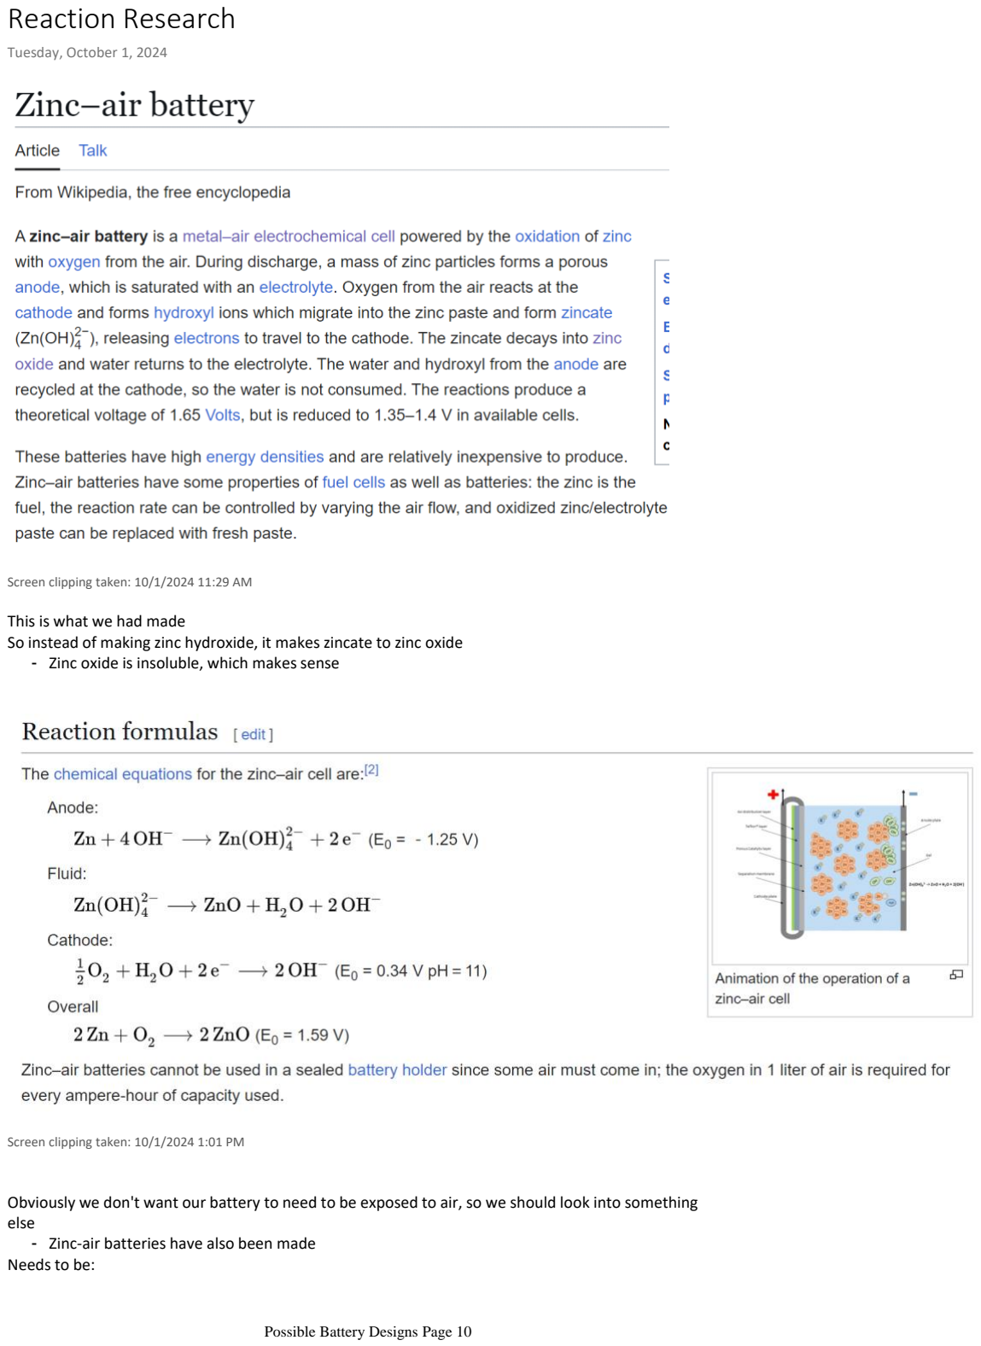
[picture p53: page 11]

Screen clipping taken: 10/1/2024 11:29 AM

This is what we had made
So instead of making zinc hydroxide, it makes zincate to zinc oxide
- Zinc oxide is insoluble, which makes sense

Screen clipping taken: 10/1/2024 1:01 PM

Obviously we don't want our battery to need to be exposed to air, so we should look into something else
- Zinc-air batteries have also been made
Needs to be:

Tuesday, October 1, 2024

Possible Battery Designs Page 10

- Safe
- Rechargeable
- Hopefully rather cheap

Possible battery types:
Nickel-Zinc (https://en.wikipedia.org/wiki/Nickel%E2%80%93zinc_battery)
- Well established, already made, not as much room to experiment

Magnesium-ion (https://en.wikipedia.org/wiki/Magnesium_battery#Secondary_cells)
May not require intercalation
Needs a suitable electrolyte to not require intercalation, and nobody has found one in 30 years

▪

○

- +2 oxidation state creates more electrostatic forces, which is a problem for intercalation

Solid-State (https://en.wikipedia.org/wiki/Solid-state_battery)
- Way too expensive (tens of thousands of dollars), we are definitely NOT doing this

Zinc-ion (https://en.wikipedia.org/wiki/Zinc-ion_battery)
- Requires intercalation
- Bigger radius than lithium and +2 oxidation state makes intercalation harder

Sodium-ion (https://en.wikipedia.org/wiki/Sodium-ion_battery)
- Requires intercalation
- HIGHLY reactive, because of sodium
- Too dangerous

Calcium-ion (https://en.wikipedia.org/wiki/Calcium_battery)
- Requires intercalation
- Highly experimental, very little research has been done
- We don't have the money to do the research

Iron-air (https://en.wikipedia.org/wiki/Metal%E2%80%93air_electrochemical_cell#Iron)
- Well established, already made, not as much room to experiment

Polymer-based? (https://en.wikipedia.org/wiki/Polymer-based_battery)
- Seems cool :)
- Very expensive

To recap:
- Magnesium-ion
- Zinc-ion
- & Polymer-based
are our best options.

Possible Battery Designs Page 11

This is a rundown and explanation of the types of batteries that matter for this project, with my (Nirvan) thoughts included.

Zinc-air batteries:
Advantages:
i. Higher energy density because air is one of the reactants, and doesn't take up space ii. Long shelf life when sealed
iii. Stable voltage up until complete battery discharge

a.

Disadvantages:
i. Needs air, so it cannot be sealed while in usage
ii. Battery is dependent on ambient conditions
iii. Horrendous cycle efficiency as low as 50%
iv. Zinc corrosion can cause explosive hydrogen gas buildup
v. Zinc forms dendrites
vi. Once its started, it (basically) can't be stopped

b.

Application
i. Vehicle propulsion
ii. Grid storage

c.

d. Decision: NO, because it needs air and is bad for rechargeable

1.

Zinc-ion
Pros:
i. Safe and non-toxic
ii. Low cost and abundant materials iii. Safer to handle
iv. Potential for high energy density

a.

Cons:
i. Dendrite formation
ii. Side reactions limit cycles iii. Hard to find good cathode

b.

Applications:
i. Grid energy storage
ii. Emergency power supplies iii. Electric vehicles
iv. Portable electronics

c.

2.

Magnesium-ion
Pros:
i. Safe and non-toxic
ii. Low cost and abundant materials
iii. Potential for even higher energy density than zinc-ion iv. Less likely for dendrite formation

a.

Cons:
i. Hard to find an electrolyte
ii. Hard to find compatible cathode materials
iii. Slower ion-diffusion (= lower current) vs. lithium-ion

b.

Applications:
i. Electric vehicles
ii. Grid energy storage

c.

3.

# Exploring Battery Types

Wednesday, October 2, 2024

Possible Battery Designs Page 12

iii. Portable electronics
Polymer-based
Pros:
i. Can be safe
ii. Can be biodegradable
iii. Many flexible designs possible for many applications

a.

Cons:
i. Lower energy density
ii. May require complex polymers

b.

Applications:
i. Flexible electronics
ii. Wearable technology

c.

4.

CURRENT PLAN: POLYMER BATTERIES & ZINC-ION BATTERIES Because…

Polymer Battery:
Biodegradable (= sustainable & safe)
This replaces long-lasting, because if it stops working, it won't harm anything, as it just breaks down into organic substances

Rechargeable (= sustainable)
In fact, the recharge rate can reach ridiculously high levels, due to the absence of intercalating metals (there is a study of an organic radical battery completely recharging in 6 seconds)

Flexible (= our application)
Safe and non-toxic with right material choices (= safe)
Lots of area for exploration (= our research)
Only major problem is lower energy density, which isn't our focus
Only worries are cost and time needed to design the battery.

Zinc-ion Battery:
The other contender was Mg-ion battery. But, Mg-ion is much more complex.
Mg-ion:
Needs an electrolyte to facilitate magnesium transport, but conventional electrolytes degrade on contact with magnesium metal

- Does not need to be intercalated
Zn-ion:
- Any electrolyte (including aqueous) works, allowing for much safer batteries
- However, it does need to be intercalated, but apparently this is not expensive.
- Higher theoretical energy density than even lithium
- Higher recharge rate (nothing compared to polymer battery)
- Extremely safe, and should last for very high number of cycles

NEXT STEPS:
Contact Mr. Green about conductive polymers, creating and designing polymers, and manipulating polymers as well.

- Study some organic chemistry and learn about the composition of polymers
Start making a zinc-ion battery (much simpler)
- Graphite, zinc, and some casing is pretty much it
- Homemade 1 Amp Hour Zinc Ion Battery - Full Instructions (https://www.youtube.com/watch?v=3tbCtJ7jWZA)
- Zinc Ion High Energy Home Made Battery - The Smallest 1Ah Cell I've Made.. (https://www.youtube.com/watch?v=HuuV3CftVhI)

Possible Battery Designs Page 13

This guy straight up just makes DIY Zinc-ion Batteries in his spare time.

Possible Battery Designs Page 14

- Homemade 1 Amp Hour Zinc Ion Battery - Full Instructions (https://www.youtube.com/watch?v=3tbCtJ7jWZA)
- Zinc Ion High Energy Home Made Battery - The Smallest 1Ah Cell I've Made.. (https://www.youtube.com/watch?v=HuuV3CftVhI)

Notes on how to design:

Cathode:
Glue paper into cylindrical oval housing
- To hold the carbon

•

Insert a strip of graphite rod into the paper
- Current collector

•

Measure out:
- 11g of carbon powder
2g of graphite powder
- For conductivity

○

•

- Stir together
Add a small amount of zinc sulfate sodium sulfate
- Make by combining 1 M zinc and sodium sulfates
- Electrolyte

•

- Mixture should be damp but not wet
- Once mixed, shovel the stuff into the paper
- Use pencil to pack it down firmly
- Seal the top with hot glue
- Pack together with yarn

Anode:
- All that is needed is zinc
Space the zinc using something like plastic mesh
- Stops zinc dendrites from shorting
- I guess not technically necessary

•

- Top up with electrolyte
- Charge the battery with 2.2 V

# Homemade Zinc-ion Battery

Friday, October 18, 2024

First Battery Page 15

NOT USED FOR DATA COLLECTION

We used a 400 mL beaker to build the battery in. First, the graphite rod was put in the beaker Next, we made the electrolyte mixture
Total:
- Roughly 33g carbon powder
- About 6g graphite powder
- Around 30 mL of 1M aqueous Zinc Sulfate + Sodium Sulfate
- A graphite rod
- A zinc strip

The powder and electrolyte made a "goop", which was then shoveled into the beaker. The 11g carbon/2g graphite powder mixture wasn't enough, so we tripled it

Produced 1.2V
However, that dropped to about .1V with a .6 ohm lightbulb
Internal Resistance:
- That a 93% decrease from the last cell
Why? We don't know yet
- 1 M Zinc Sulfate + Sodium Sulfate is isoelectronic to 2 M zinc sulfate, but the old cell had 3 M NaCl Ions move at around the same speed, so a single ion holding more charge is more efficient
Thus, SO4

2-

is more efficient than Cl⁻

, and Zn²⁺ is more efficient than Na⁺ ▪

○

- However, most batteries have resistances in the hundredths of Ohms Current Produced:

, which is about what we measured (11 mA measured) So, we need to get that resistance down a lot.

We were able to charge the battery: it drew .62 A at around 2 V, which is a good charging speed
Max voltage was 1.8 V after charging for 10 mins, the actual maximum voltage (research) is around 2.2 V

This was very good, even though we forgot to add as much electrolyte as we were supposed to.
NEXT STEP: Add more electrolyte, try changing electrolyte and carbon mixtures, etc.

# The Beaker Battery

Tuesday, October 22, 2024

First Battery Page 16

NOT USED FOR DATA COLLECTION

We are now using our own container for the battery, 3D printed from ABS plastic

DXF diagram:

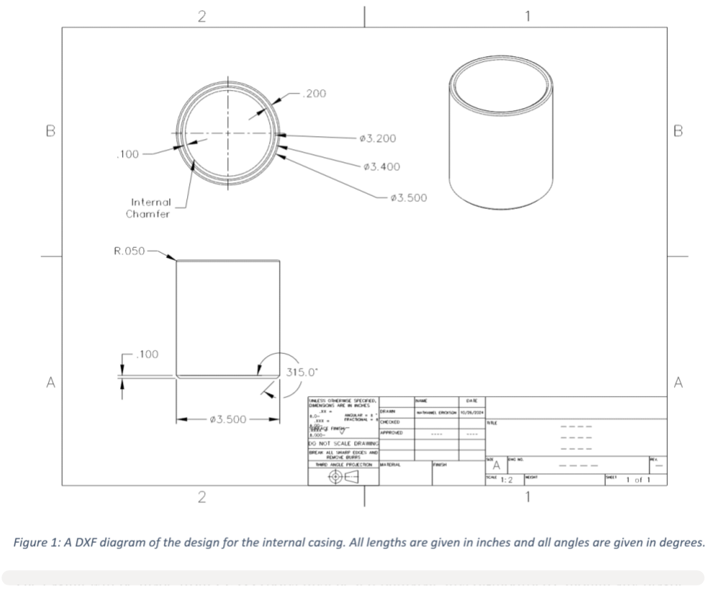
[picture p54: figure]

It is a 4-inch tall, 1.75 inch radius cylinder. We went through the same steps, but we hit the max solubility of zinc and sodium sulfates.

Materials used:
- 33g carbon powder (affects capacity)
- 6g graphite powder (affects internal resistance and capacity)
- 200 mL of 1.5M Zinc Sulfate and Sodium Sulfate (affects internal resistance)
- Graphite rod (cathode)
- Zinc strip (anode)
Once again, we made a "goop" that we put in the container, but now we filled the container with electrolyte so the conductivity would be much higher.

# The Big Battery

Wednesday, October 30, 2024

First Battery Page 17

As of now, the main issue is too high internal resistance. The ways to decrease this are:
- Concentration of electrolyte
- Surface area of electrodes
- Temperature

We will test the battery in a circuit tomorrow.

This battery got even worse

First Battery Page 18

NOT USED FOR DATA COLLECTION

We still have many mistakes…

The graphite is surrounded by the powder mixture within its own casing
- This casing is tightly sealed
The zinc is outside of this casing, but electrolyte floods the two electrodes Plastic mesh between the graphite and zinc

At 2:40 pm, round 3 battery is done.
Cathode: 20 g carbon powder, 8 g graphite powder, sealed inside cathode casing with graphite rod sticking out
Anode: the zinc strip
Both are placed in a 100 mL beaker (to minimize volume and maximize surface area)
The beaker is then topped up with as much electrolyte as possible (50 mL)

# Round 3

Monday, November 11, 2024

First Battery Page 19

NOT USED FOR DATA COLLECTION

Added 39.23 g ZnSO4 to 80mL water for about 3M solution of around 100 Ml

Added 15.56 g activated charcoal (carbon)
Added 6.33g graphite
Mixed together in bowl, combined with 25 mL of electrolyte

Smushed inside graphite foil
Wrapped in filter paper and placed in casing with zinc metal and electrolyte Did not work, probably because of the graphite foil

# Data collection time

Friday, December 20, 2024 12:04 PM

The Trials Page 20

Battery works today
Replaced graphite foil with graphite rod
Gave 1.2 volts
We are charging it, then we will do a discharge test

Using power supply as emf, terminals as V, and power supply's current as I,

Gives the internal resistance as:
At 1 V, .27 A charge rate: 1.574
At 2 V, .66 A charge rate: 1.280
At 2.49 V, 1.04 A charge rate: 1.012

Why is resistance going down with current?
After charging, there is no voltage across the battery We may have discharged it by accident

Flipping the current seemed to resolve the problem

When the cathode and the anode touch, then the current that the power supply reads increases, on the other hand, when the two are separated, then the current read is 0

# Finally, it works

Saturday, December 21, 2024 11:53 AM

The Trials Page 21

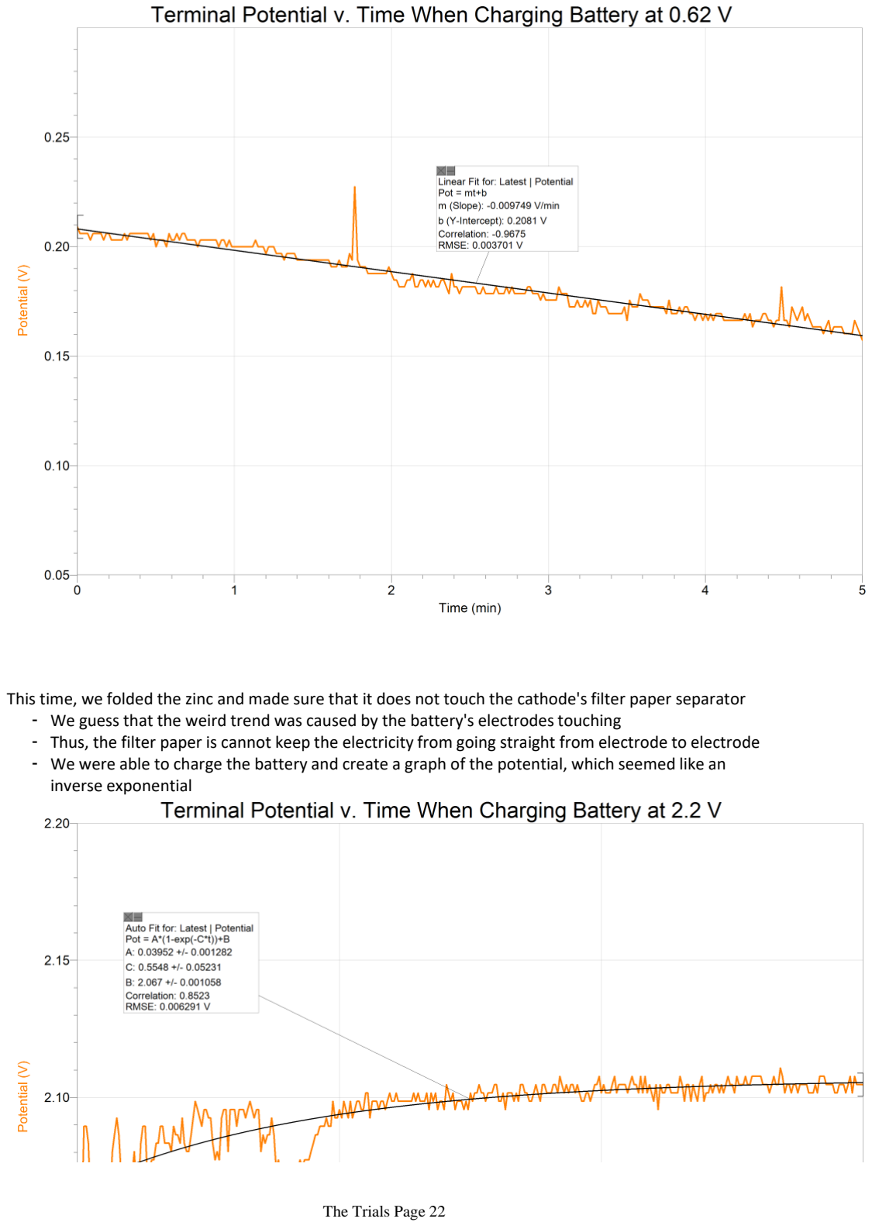
[picture p55: page 23]

This time, we folded the zinc and made sure that it does not touch the cathode's filter paper separator
- We guess that the weird trend was caused by the battery's electrodes touching
- Thus, the filter paper is cannot keep the electricity from going straight from electrode to electrode We were able to charge the battery and create a graph of the potential, which seemed like an inverse exponential

The Trials Page 22

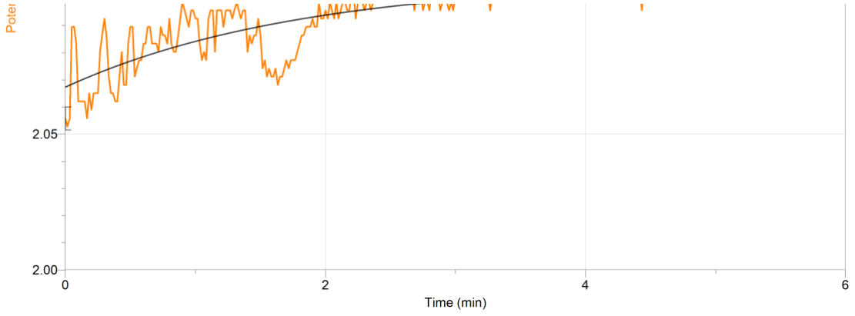
[picture p56: figure]

We cannot find the internal resistance because we do not have a resistor.

The Trials Page 23

FIRST TEST WITH DATA COLLECTION

15.56 g charcoal
6.76 g graphite
25 mL electrolyte

1 OHM INTERNAL RESISTANCE!!!

1.060 v across battery to begin (starting emf)
11.25 internal resistance measured

In second discharge test:
Starting emf: 1.28 V, Internal resistance at beginning was 4.372 ending values: 0.361 V, 10.755

Time to recharge:

# Round 2

Saturday, December 28, 2024 5:26 PM

The Trials Page 24

- Test ni-mh and li-ion batteries
- Test capacitors
- Try zinc chloride and other, lighter things

# Stuff for fair

Tuesday, December 31, 2024 12:47 PM

The Trials Page 25

3.74 g graphite
9.22 g activated carbon
22.3 g zinc sulfate in 50 mL water for 3M concentration
This time, the battery will be charged and discharged for longer. The graphite and activated carbon have been both halved, so the discharge curves are expected to hold half the charge

# Making the second battery

Wednesday, January 8, 2025 2:38 PM

Iteracion dos Page 26

Emf can't be measured while battery is charging
But, if the battery is momentarily disconnected, the emf can be measured
So, a circuit that automatically disconnects, measures the emf, then reconnects could work to measure emf effectively

Materials:
- The battery
- The power supply
- Voltage probe
- A relay (aka electromagnetic switch)
- A microcontroller (in this case, an arduino)

Hook the battery up to charge, with voltage probe across the battery terminals and a relay in the circuit

1.

Use the arduino to activate the relay after 4 minutes, leave the circuit open for a minute, then switch the relay back again, continuously.

2.

Have logger pro pick up the data every 5 minutes, set so it collects the emf while the circuit is open.

3.

This circuit will allow for a better measurement of the emf

How to calculate internal resistance while running?
Could use a second relay and momentarily measure the current and voltage across a known resistance to find the internal resistance (very complicated)

By Kirchhoff's Second Law, | , or
, all of which can be calculated during the experiment

How to calculate the current?

# Charging plan

Thursday, January 9, 2025 5:23 PM

Iteracion dos Page 27

Materials for discharge circuit:

Volt probe
Current probe
Resistance box
Battery

Procedure
1. Wire the voltage probe across the the battery
Wire the resistance box across the battery, with the current probe in series (disconnect circuit though to prevent discharge)

2.

3. Connect current probe and voltage probe to labquest
4. Change labquest to sample 6/min for 1080 min
5. Reconnect circuit, then leave labquest running

# Discharge Circuit

Tuesday, January 14, 2025 10:02 PM

Altering electrolyte composition Page 28

We are replacing zinc sulfate with zinc chloride
Zinc chloride used in cathode and electrolyte with a graphite rod
a. Can also be replaced with zinc sulfate electrolyte

1.

New graphite and carbon amounts
a. 9.88g carbon
b. 11.19g graphite
c. Zinc chloride electrolyte

2.

3. Graphite foil battery, using old carbon/graphite concentrations and zinc chloride

Anode will forever be constant: zinc metal

# Zinc Chloride tests

Thursday, January 16, 2025 11:57 PM

Altering electrolyte composition Page 29

Iteration 1: graphite rod, zinc sulfate goop, zinc sulfate electrolyte Iteration 2: half the goop (carbon powders) of iteration 1
Iteration 3: Graphite rod, zinc chloride goop, zinc chloride electrolyte Iteration 4: 1:1 ratio of powders from Iteration 3

Next:
Iteration 5: cathode 3 in zinc sulfate

Iteration 6: graphite foil, manganese oxide

16 g carbon
7.77 g graphite
6.47 g manganese dioxide

Used distilled water instead

86 g zncl2 to make 6 molar

Sadly, charging produced chlorine gas, and experimentation had to be shortened down

- Time to begin paper

# Iterations List

Friday, January 17, 2025 10:27 AM

Altering electrolyte composition Page 30
