farvanyoshi/battery-science-project/assets/figures/charge-current-2.pdf

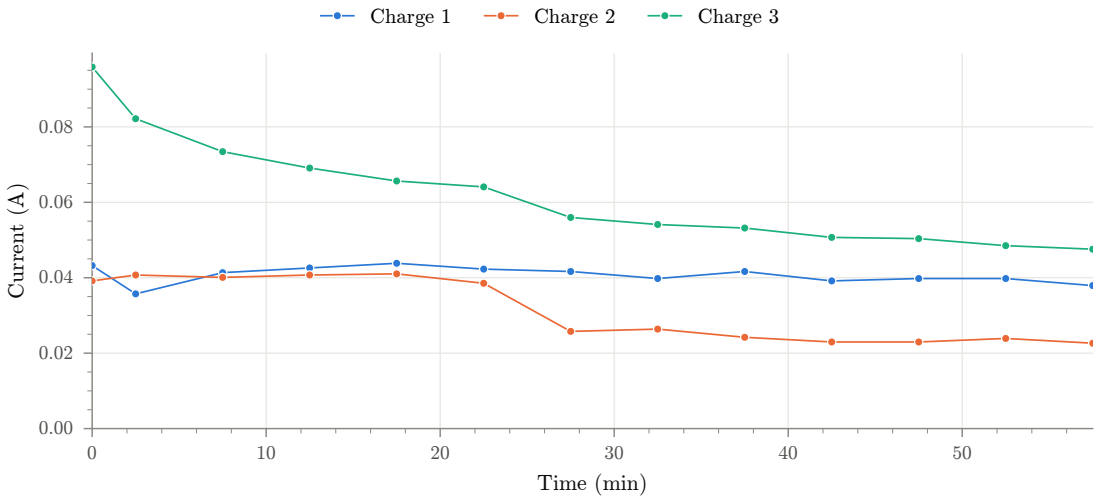
[picture p57: page 1]
Time (min); Current (A); Charge 1; Charge 2; Charge 3
