farvanyoshi/battery-science-project/assets/figures/charge-current-3.pdf

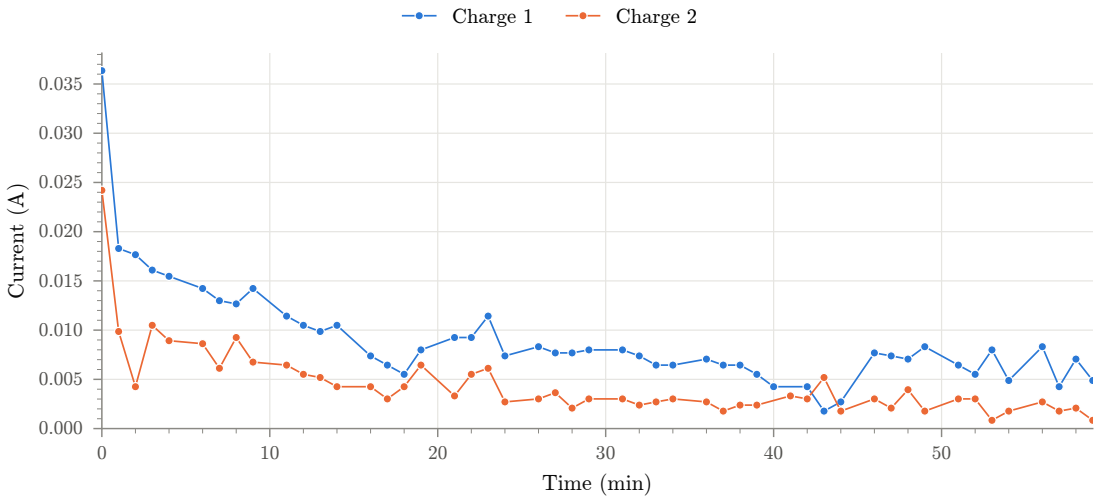
[picture p58: page 1]
Time (min); Current (A); Charge 1; Charge 2
