farvanyoshi/battery-science-project/assets/figures/current-2-d1.pdf

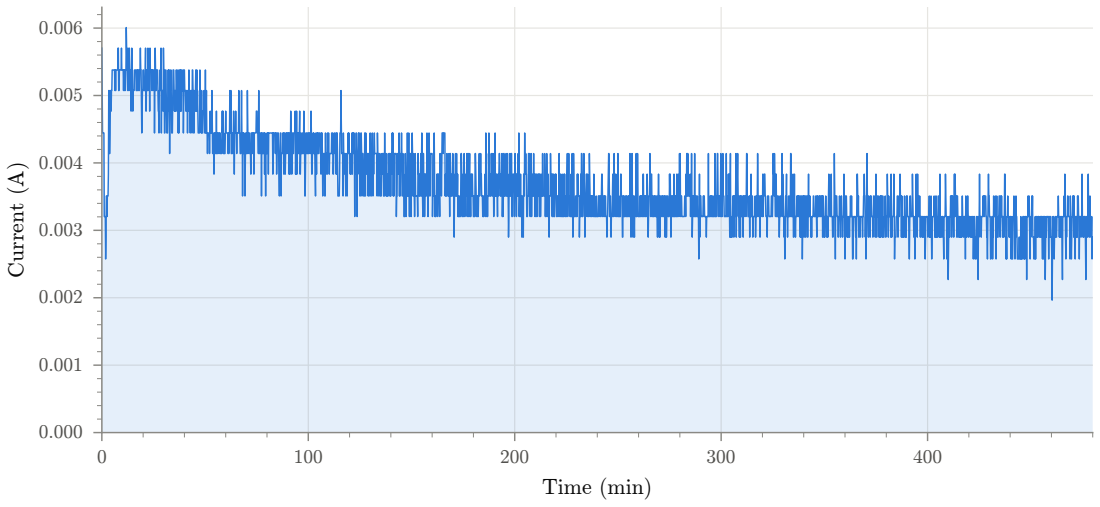
[picture p60: page 1]
Time (min); Current (A)
