farvanyoshi/battery-science-project/assets/figures/current-2-d2.pdf

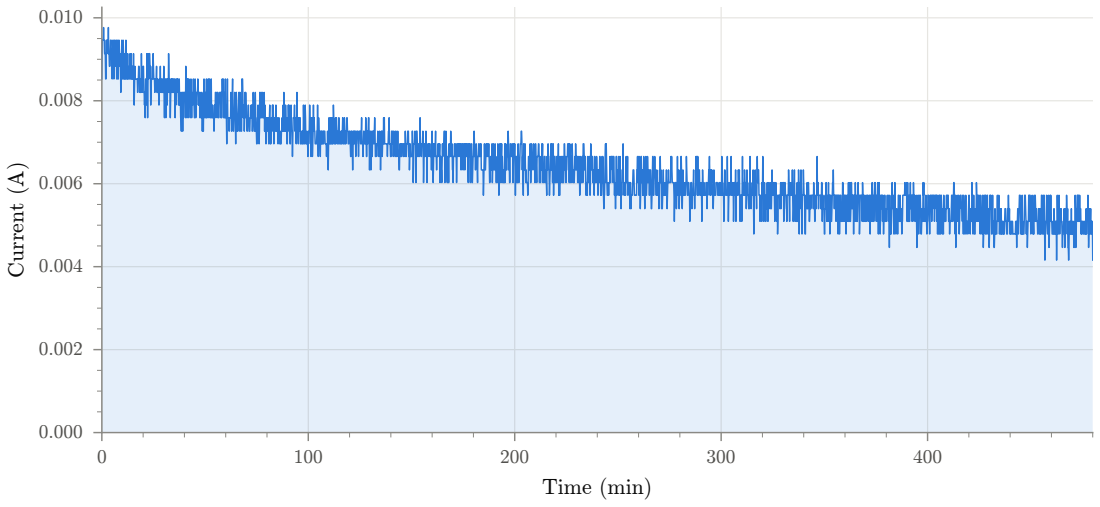
[picture p61: page 1]
Time (min); Current (A)
