farvanyoshi/battery-science-project/assets/figures/current-2-d3.pdf

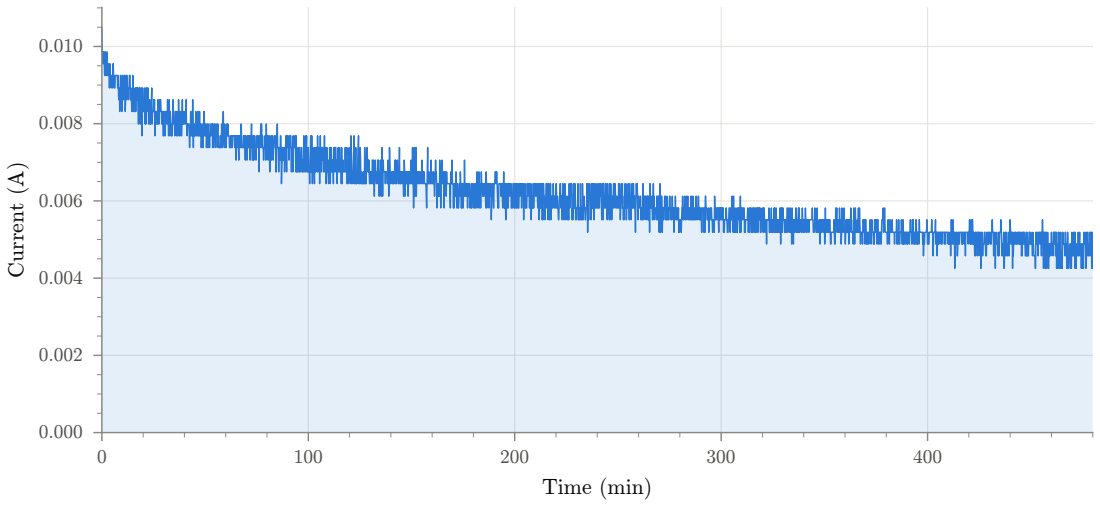
[picture p62: page 1]
Time (min); Current (A)
