farvanyoshi/battery-science-project/assets/figures/current-3-d1.pdf

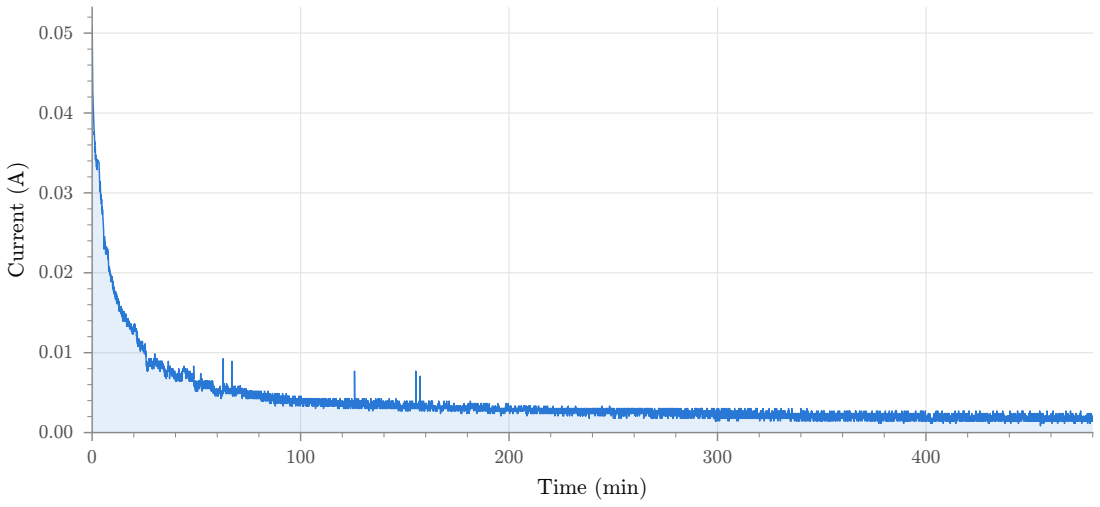
[picture p63: page 1]
Time (min); Current (A)
