farvanyoshi/battery-science-project/assets/figures/current-3-d2.pdf

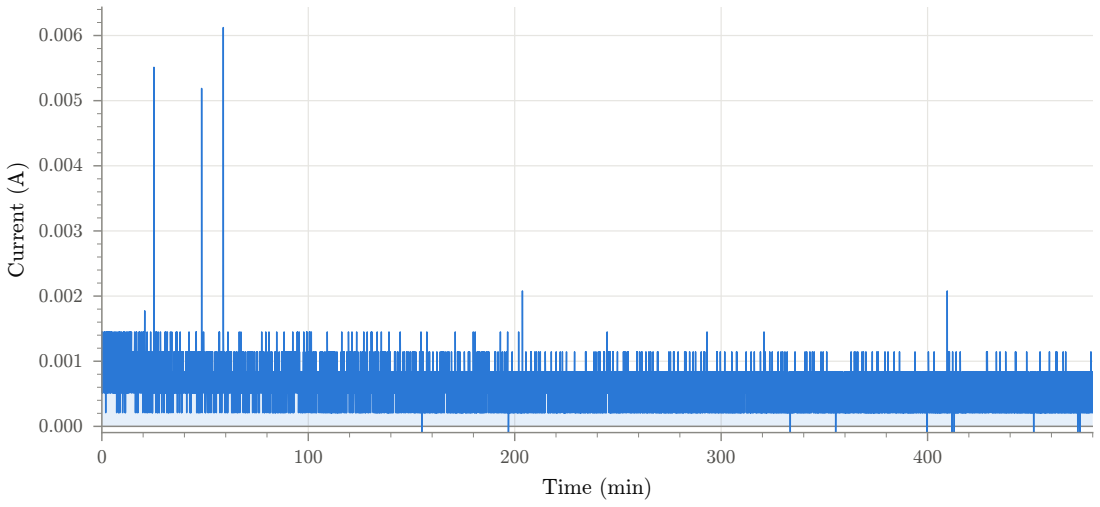
[picture p64: page 1]
Time (min); Current (A)
