farvanyoshi/battery-science-project/assets/figures/current-3-d3.pdf

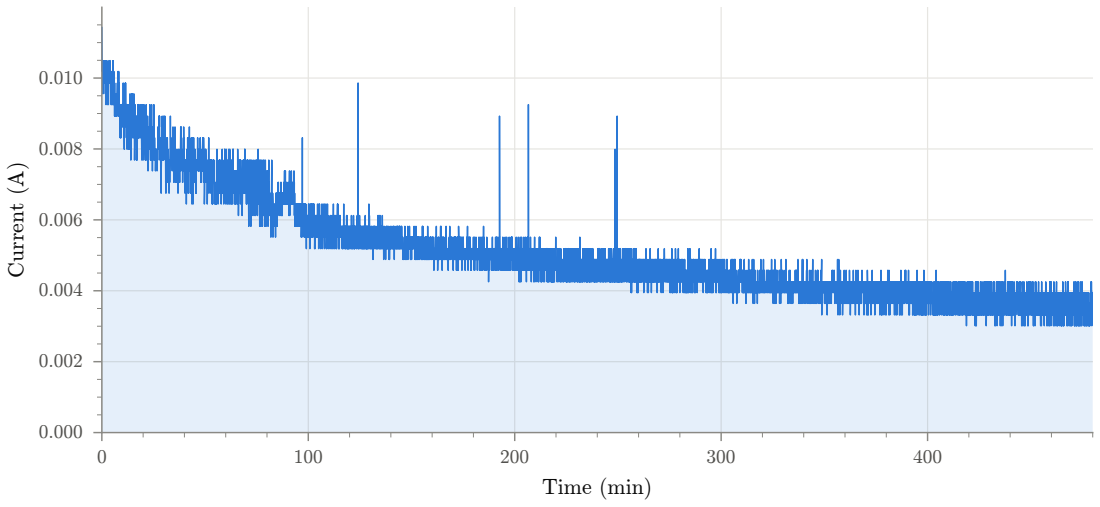
[picture p65: page 1]
Time (min); Current (A)
