farvanyoshi/battery-science-project/assets/figures/current-3b.pdf

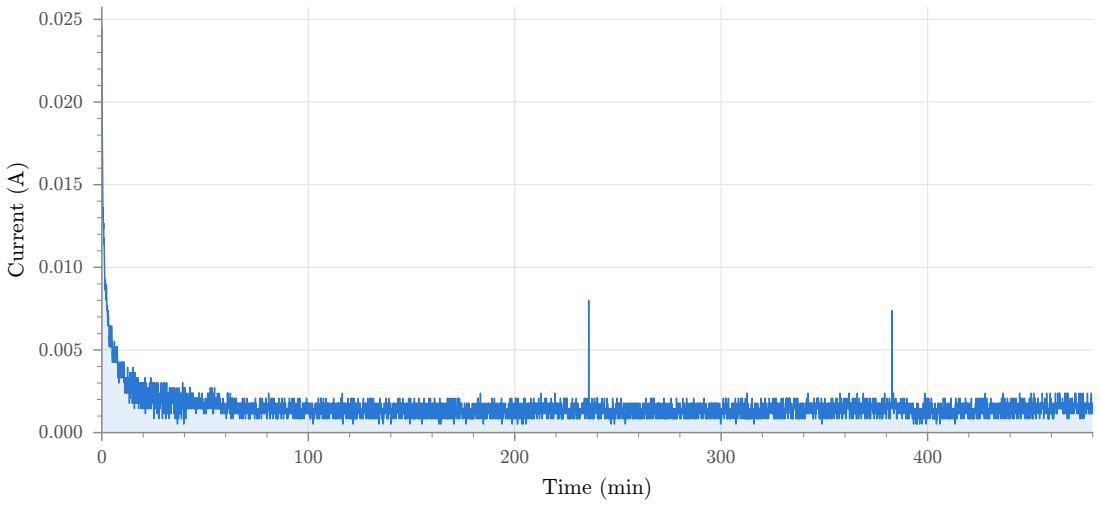
[picture p66: page 1]
Time (min); Current (A)
