farvanyoshi/battery-science-project/assets/figures/current-4-d1.pdf

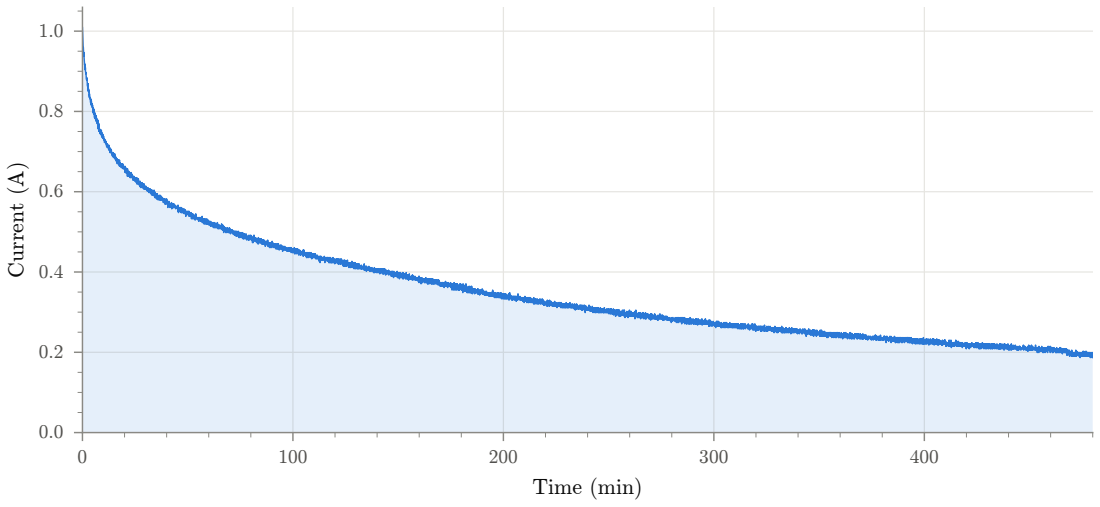
[picture p67: page 1]
Time (min); Current (A)
