farvanyoshi/battery-science-project/assets/figures/current-4-d2.pdf

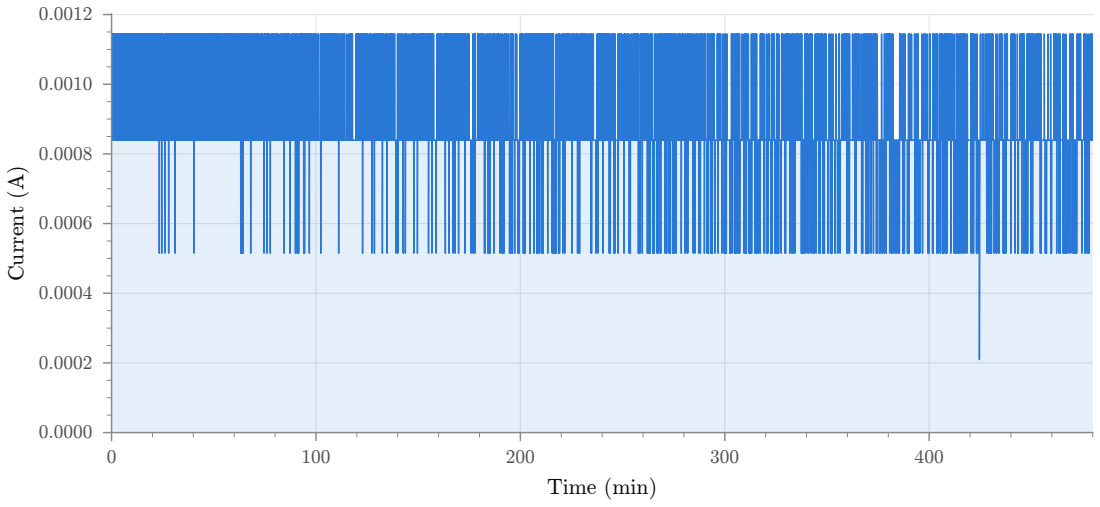
[picture p68: page 1]
Time (min); Current (A)
