farvanyoshi/battery-science-project/assets/figures/current-4-d3.pdf

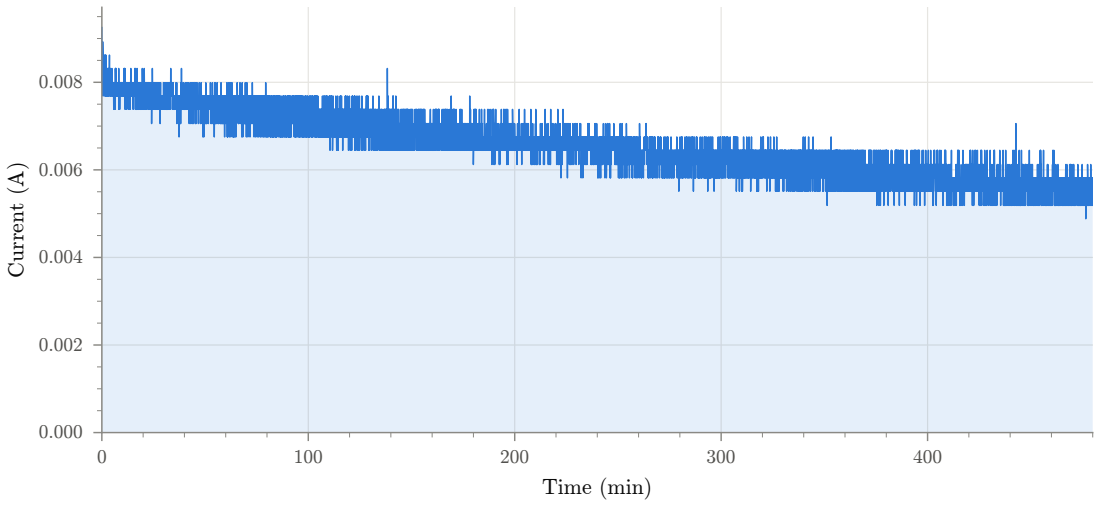
[picture p69: page 1]
Time (min); Current (A)
