farvanyoshi/battery-science-project/assets/figures/current-5-d1.pdf

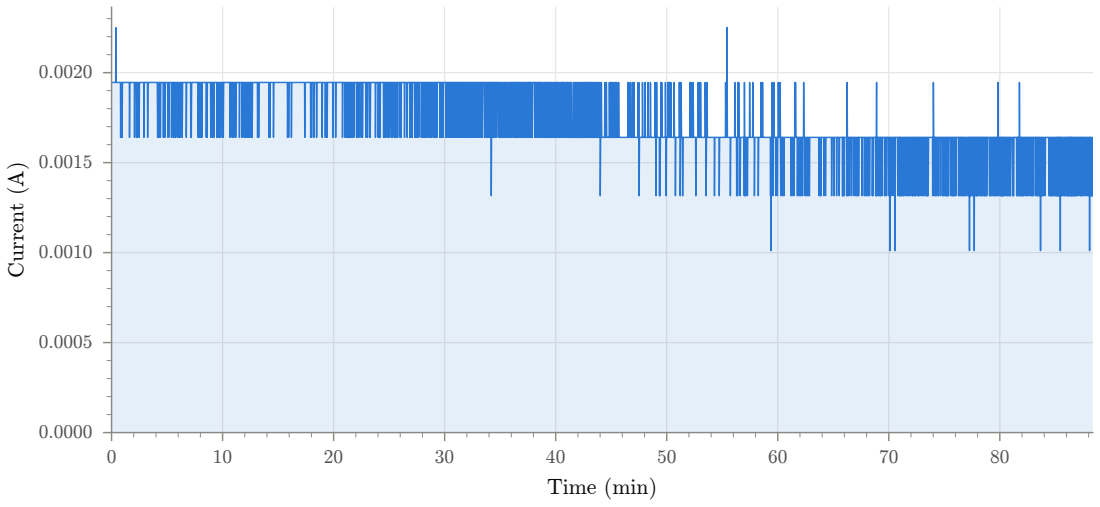
[picture p70: page 1]
Time (min); Current (A)
