farvanyoshi/battery-science-project/assets/figures/current-5-d2.pdf

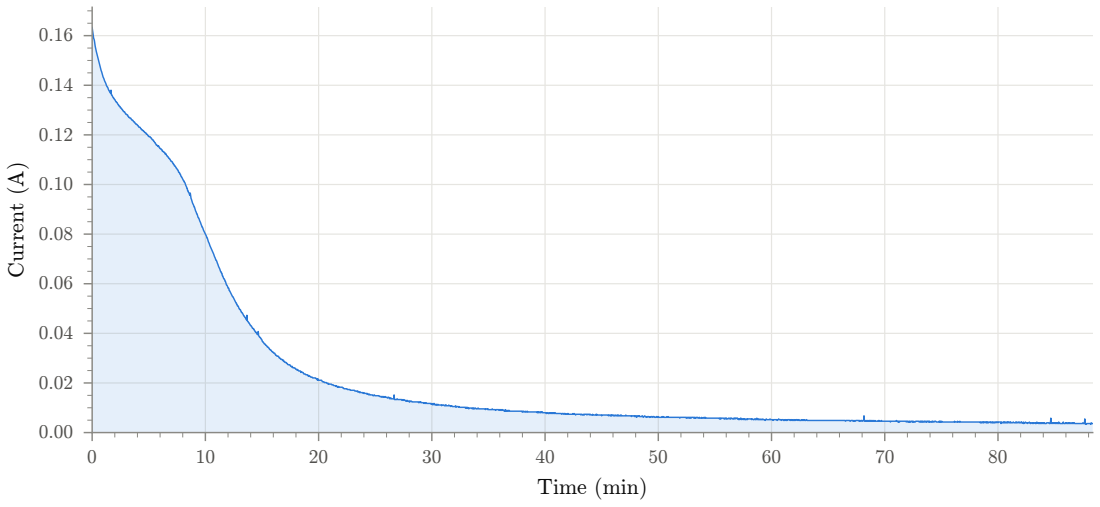
[picture p71: page 1]
Time (min); Current (A)
