farvanyoshi/battery-science-project/assets/figures/current-nimh.pdf

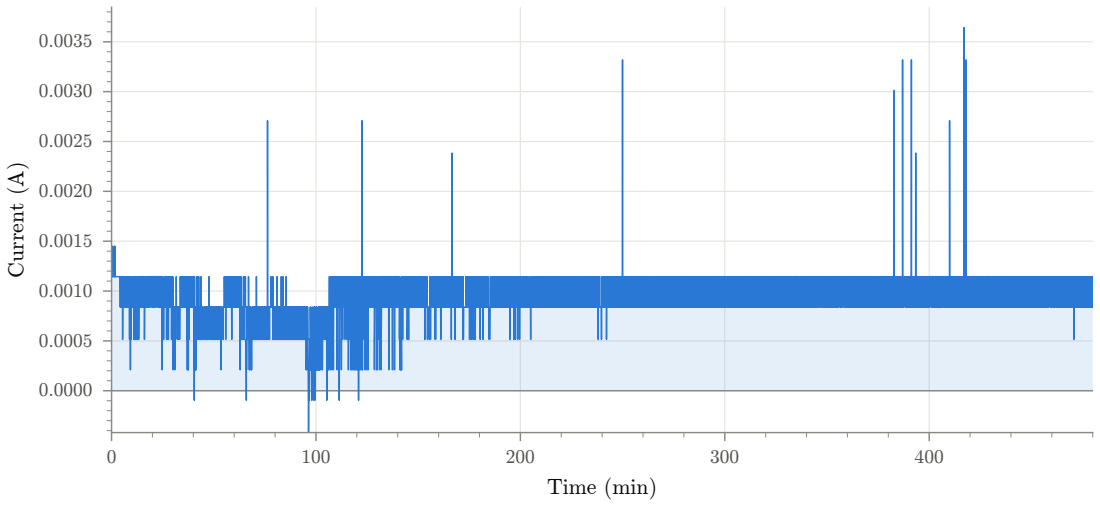
[picture p72: page 1]
Time (min); Current (A)
