farvanyoshi/battery-science-project/assets/figures/emf-2.pdf

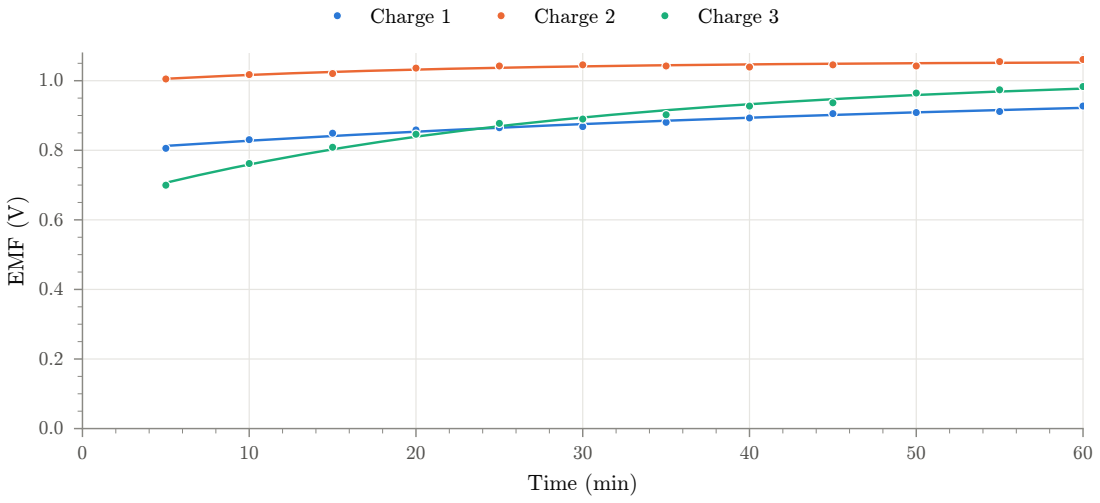
[picture p73: page 1]
Time (min); EMF (V); Charge 1; Charge 2; Charge 3
