farvanyoshi/battery-science-project/assets/figures/emf-3.pdf

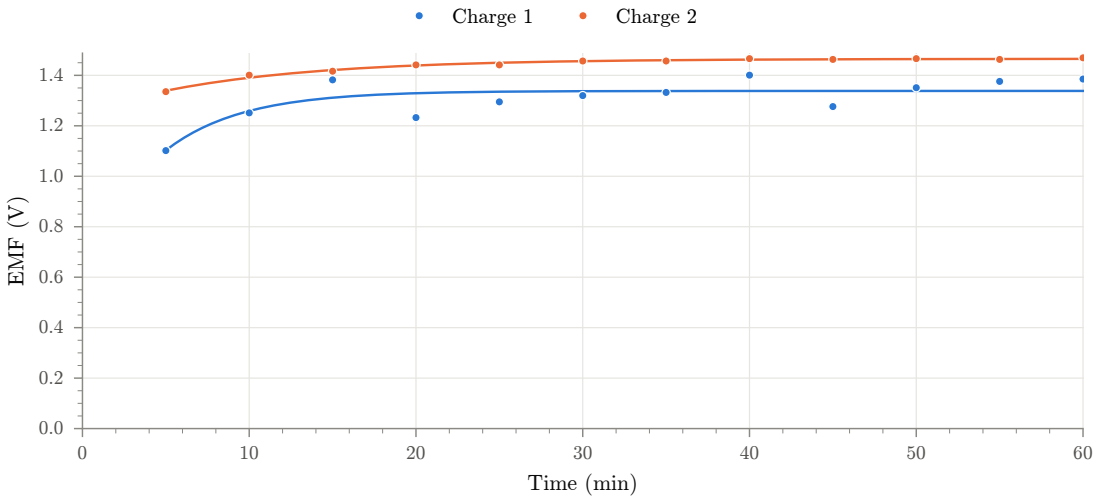
[picture p74: page 1]
Time (min); EMF (V); Charge 1; Charge 2
