farvanyoshi/battery-science-project/assets/figures/emf-4.pdf

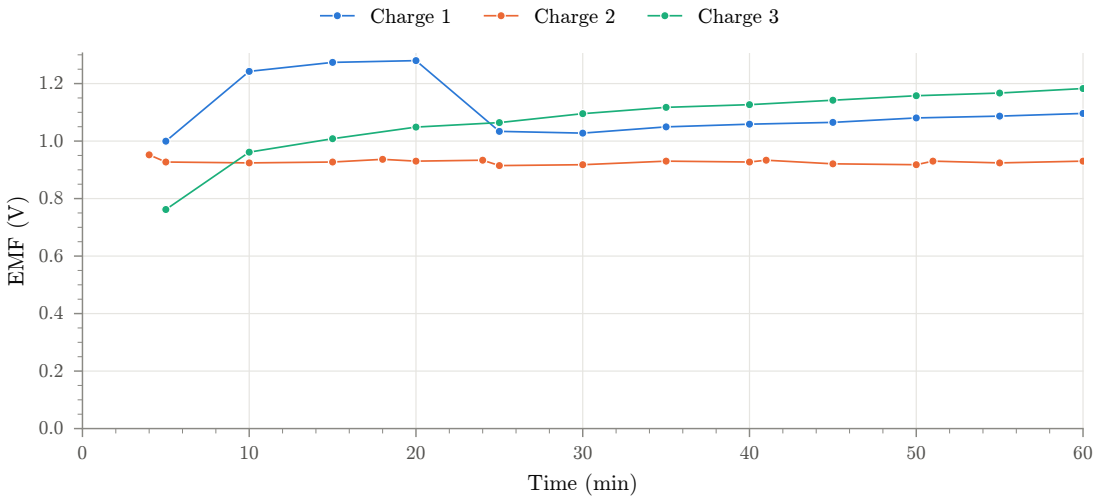
[picture p75: page 1]
Time (min); EMF (V); Charge 1; Charge 2; Charge 3
