farvanyoshi/battery-science-project/assets/figures/normalized-current.pdf

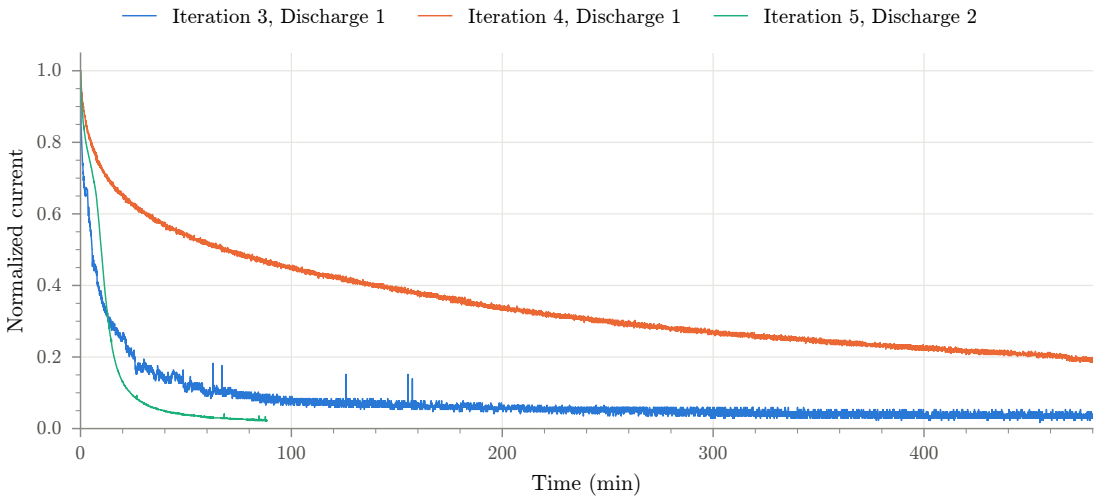
[picture p76: page 1]
Time (min); Normalized current; Iteration 3, Discharge 1; Iteration 4, Discharge 1; Iteration 5, Discharge 2
