farvanyoshi/battery-science-project/assets/figures/power-2.pdf

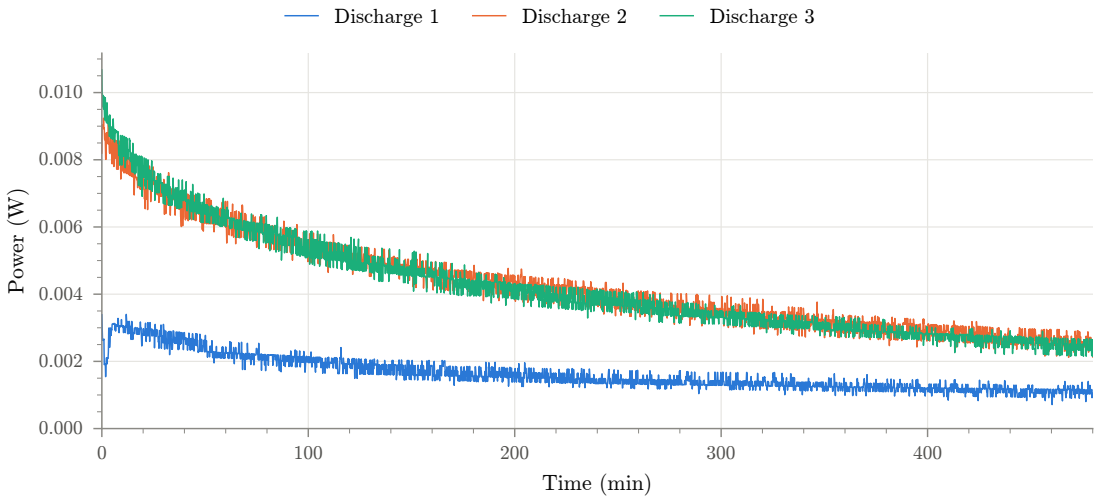
[picture p77: page 1]
Time (min); Power (W); Discharge 1; Discharge 2; Discharge 3
