farvanyoshi/battery-science-project/assets/figures/power-3.pdf

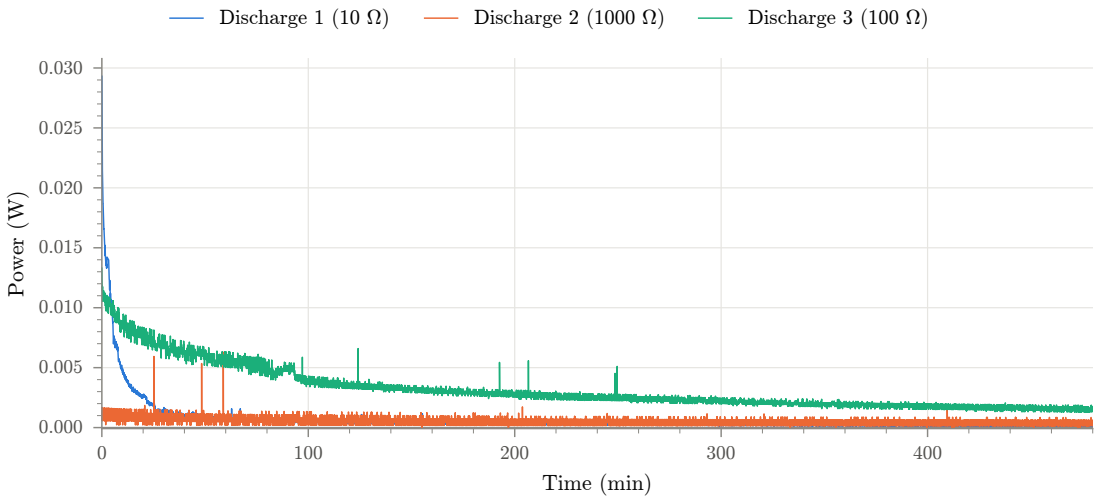
[picture p78: page 1]
Time (min); Power (W); Discharge 1 (10 ); Discharge 2 (1000 ); Discharge 3 (100 )
