farvanyoshi/battery-science-project/assets/figures/power-4.pdf

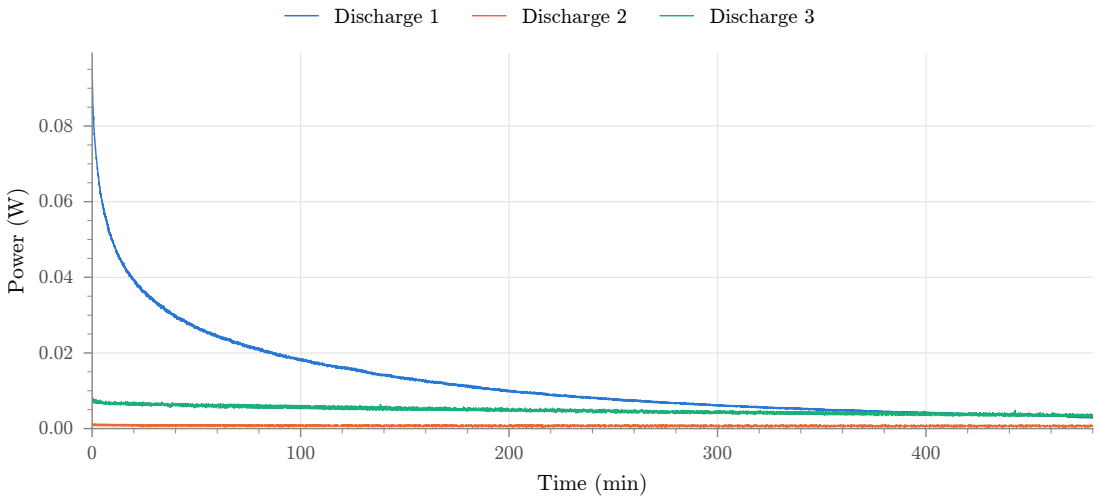
[picture p79: page 1]
Time (min); Power (W); Discharge 1; Discharge 2; Discharge 3
