farvanyoshi/battery-science-project/assets/figures/power-5.pdf

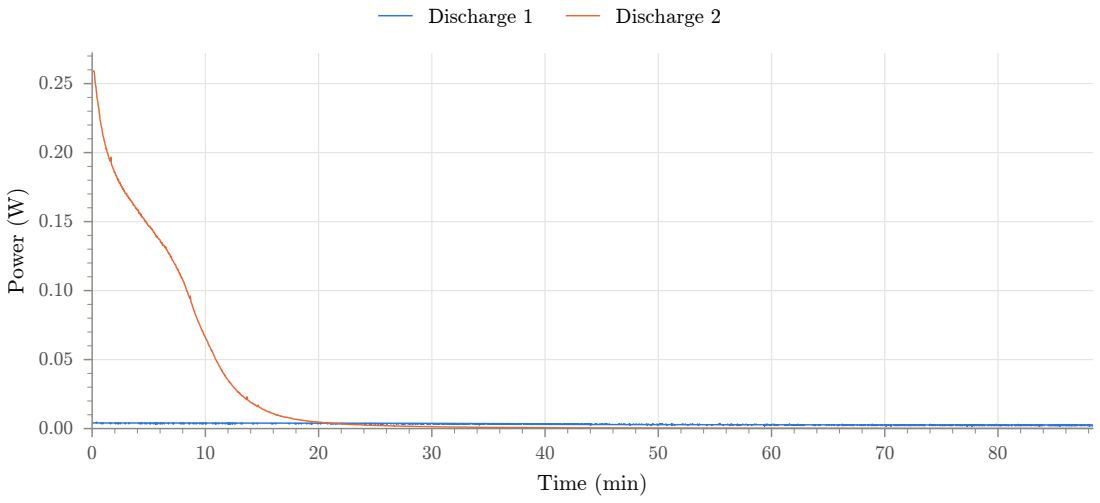
[picture p80: page 1]
Time (min); Power (W); Discharge 1; Discharge 2
