farvanyoshi/battery-science-project/assets/figures/normalized-potential.pdf

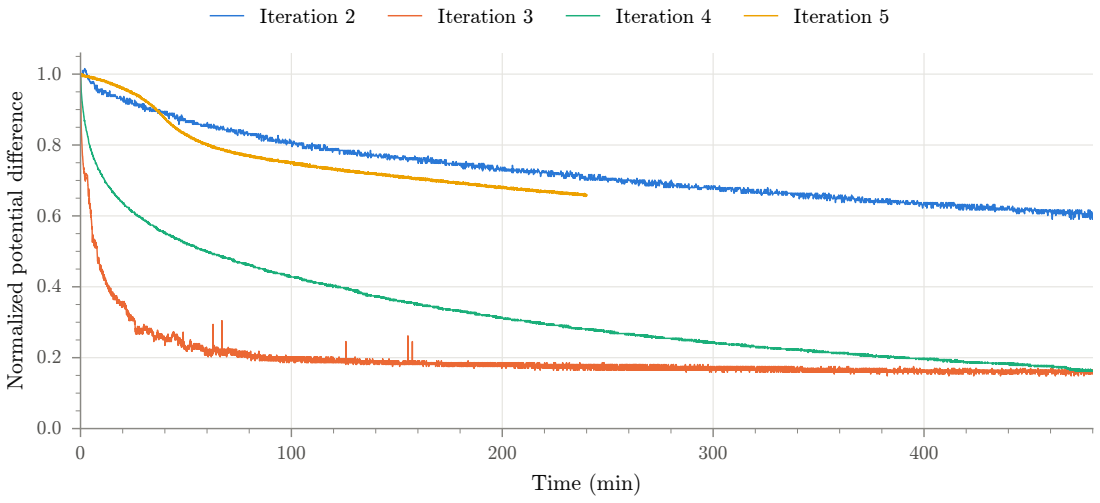
[picture p81: page 1]
Time (min); Iteration 2; Iteration 3; Iteration 4; Iteration 5

Normalized potential difference
