farvanyoshi/battery-science-project/assets/figures/potential-2.pdf

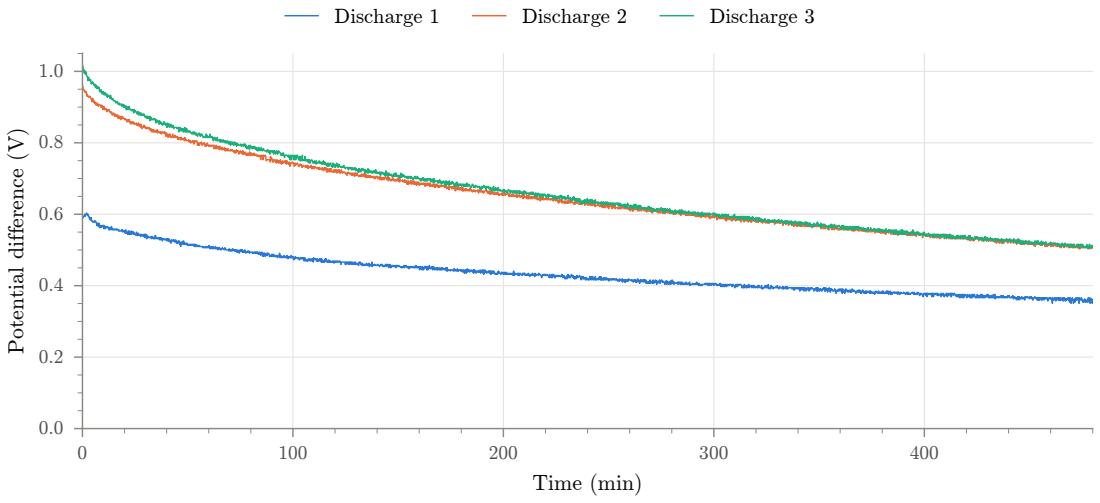
[picture p82: page 1]
Time (min); Potential difference (V); Discharge 1; Discharge 2; Discharge 3
