farvanyoshi/battery-science-project/assets/figures/potential-3.pdf

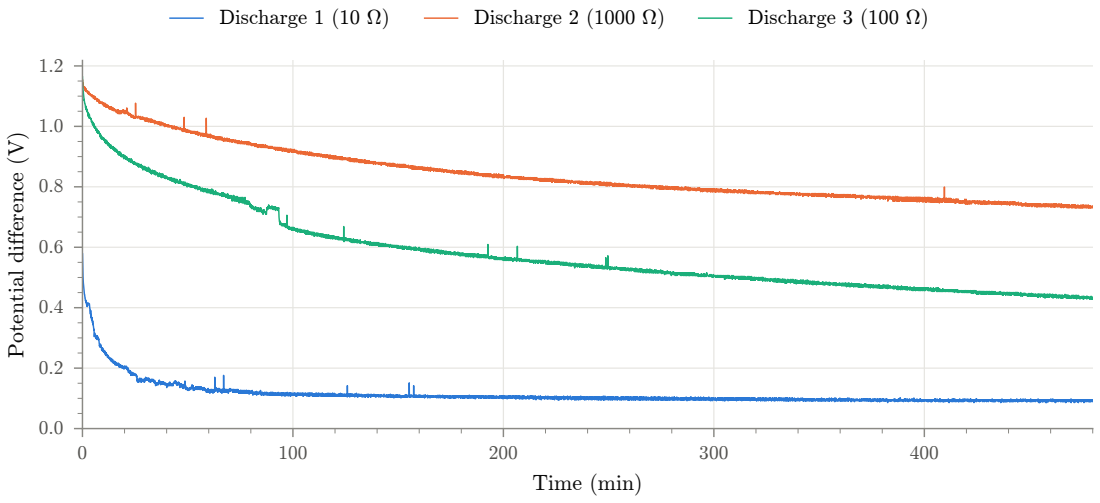
[picture p83: page 1]
Time (min); Potential difference (V)
