farvanyoshi/battery-science-project/assets/figures/potential-3b.pdf

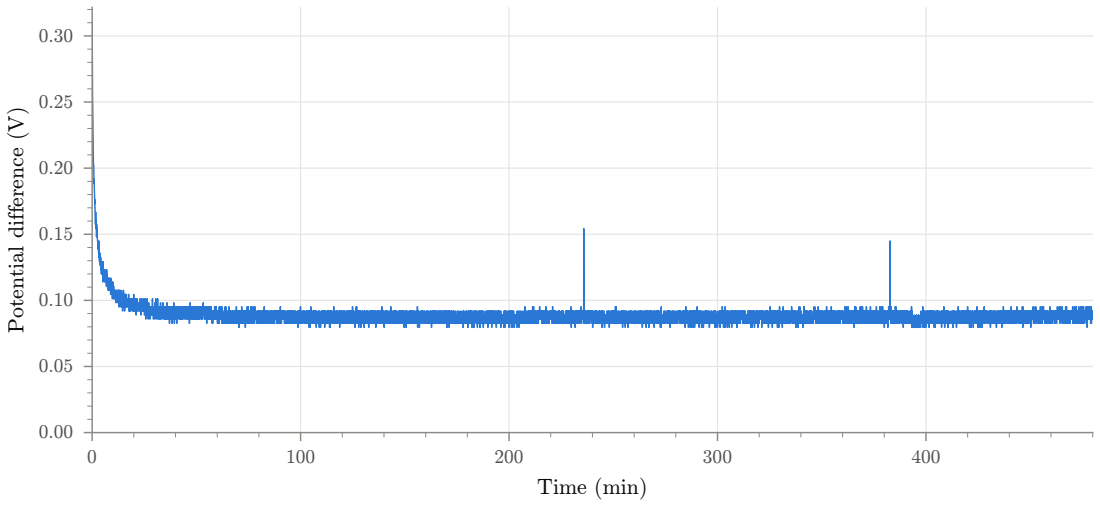
[picture p84: page 1]
Time (min); Potential difference (V)
