farvanyoshi/battery-science-project/assets/figures/potential-4.pdf

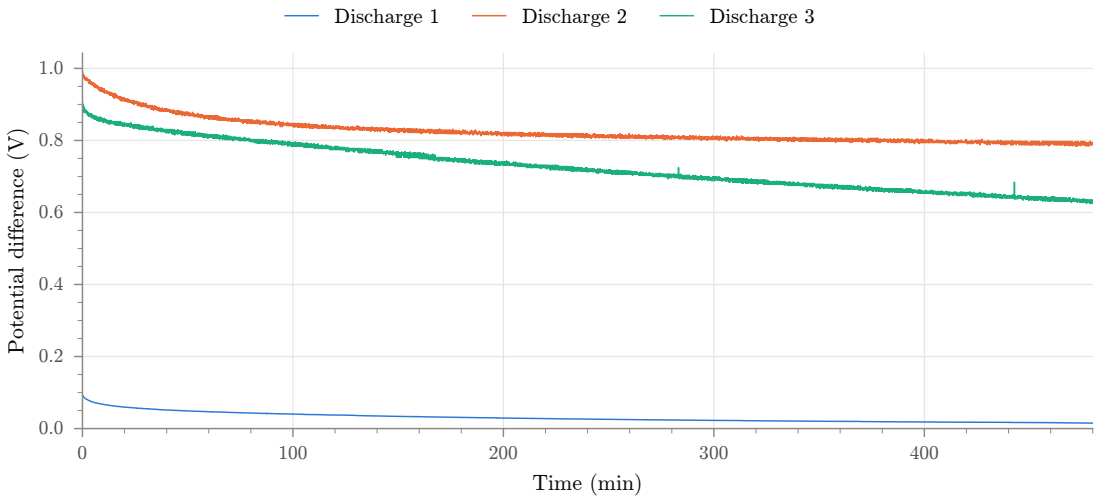
[picture p85: page 1]
Time (min); Potential difference (V); Discharge 1; Discharge 2; Discharge 3
