farvanyoshi/battery-science-project/assets/figures/potential-5.pdf

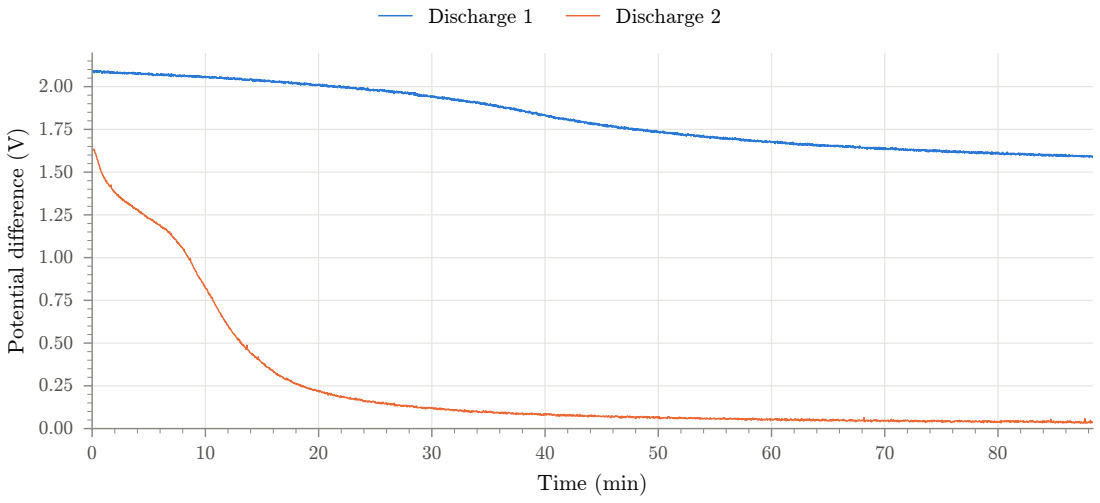
[picture p86: page 1]
Time (min); Potential difference (V); Discharge 1; Discharge 2
