farvanyoshi/battery-science-project/assets/figures/potential-nimh.pdf

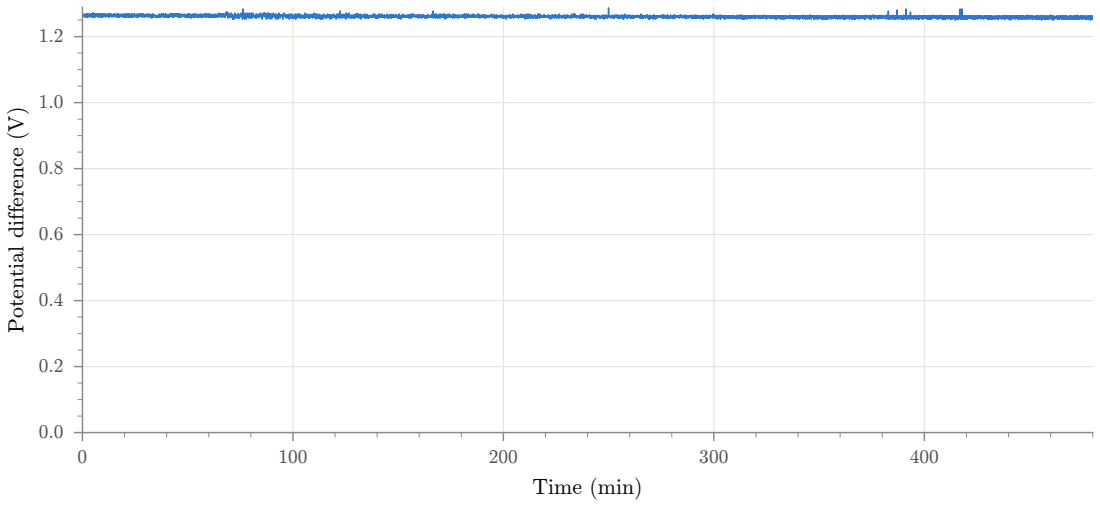
[picture p87: page 1]
Time (min); Potential difference (V)
