farvanyoshi/battery-science-project/(commit log)

2026-10-30 Add raw Logger Pro data with provenance notes
    [dataset_101.csv, dataset_110.csv, dataset_113.csv, dataset_114.csv, dataset_117.csv, dataset_118.csv, dataset_124.csv, dataset_125.csv]
2026-10-30 Add zinclab analysis pipeline, tests and regenerated figures
    [curve-fits.csv, effective-capacity.csv, figure-readouts.csv, figures.csv, fits.csv, internal-resistance.csv, readouts.csv]
2026-10-30 Correct values that disagree with the data and add a verification report
    The effective capacity and energy tables summed the samples instead of
    integrating over time, and three cells read the wrong columns. The tables
    now use the integrals, and the sentences comparing them are updated. Four
    numbers in the text are corrected to match the data. docs/VERIFICATION.md
    lists every check and every change.
2026-10-30 Fix typos and grammar in the paper
    Spelling, grammar and copy-paste slips only. Also corrects the captions of
    the Iteration 3 and 4 charging-current graphs (they said Iteration 2), the
    voltage probe being "in series" (it is in parallel, as the schematic shows),
    the charge numbers in the Iteration 4 charging-current discussion, and the
    index in the trapezoidal sum. An unfinished sentence ("Nevertheless, NiMH
    are useful for") is removed and the power supply photo gets a caption.
2026-10-30 Move the Logger Pro files into their own folder
    [curve-fits.csv, dataset_101.csv, dataset_110.csv, dataset_113.csv, dataset_114.csv, dataset_117.csv, dataset_118.csv, dataset_124.csv]
2026-10-30 Add the data book as the raw data
    [the-data-book.xlsx]
2026-10-30 Split the data book into tidy CSV files
    [aa-discharge.csv, charge-1.csv, charge-2-emf.csv, charge-2.csv, charge-3.csv, cleaning.csv, discharge-1.csv, discharge-2.csv]
2026-10-30 Build the graphs and tables from the tidy data
    [effective-capacity.csv, fits.csv, readouts.csv]
2026-10-30 Write the curve fits to 6 significant figures so they match on every machine
    [fits.csv]
2026-11-02 Update README with Iteration 5 discharge details
    Clarified the discharge characteristics of Iteration 5 and noted the safety concern regarding chlorine gas release during charging.
